ab0tj/MiniSys/CheapBus Pinout.xlsx

Pin | Name | Description | Type | Note
1 | GND | Ground | Power
2 | GND | Ground | Power
3 | GND | Ground | Power
4 | GND | Ground | Power
5 | GND | Ground | Power
6 | A23 | Address bus | Signal
7 | A22 | Address bus | Signal
8 | A21 | Address bus | Signal
9 | A20 | Address bus | Signal
10 | A19 | Address bus | Signal
11 | A18 | Address bus | Signal
12 | A17 | Address bus | Signal
13 | A16 | Address bus | Signal
14 | A15 | Address bus | Signal
15 | A14 | Address bus | Signal
16 | A13 | Address bus | Signal
17 | A12 | Address bus | Signal
18 | A11 | Address bus | Signal
19 | A10 | Address bus | Signal
20 | A9 | Address bus | Signal
21 | A8 | Address bus | Signal
22 | A7 | Address bus | Signal
23 | A6 | Address bus | Signal
24 | A5 | Address bus | Signal
25 | A4 | Address bus | Signal
26 | A3 | Address bus | Signal
27 | A2 | Address bus | Signal
28 | A1 | Address bus | Signal
29 | A0 | Address bus | Signal
30 | IOR* | IO Read | Signal
31 | IOW* | IO Write | Signal
32 | MEMR* | Memory Read | Signal
33 | MEMW* | Memory Write | Signal
34 | MOVL* | Memory Overlay Active | Signal | Similar to S100 PHANTOM* line
35 | IO16* | IO 16 bit | Signal | Addressed IO device supports 16 bit transfer
36 | M16* | Memory 16 bit | Signal | Addressed memory device supports 16 bit transfer
37 | BHE* | Bus High Enable | Signal
38 | CLK1 | System Clock | Signal
39 | CLK2 | Aux clock 1 | Signal
40 | CLK3 | Aux clock 2 | Signal
41 | CLK4 | Aux clock 3 | Signal
42 | IRQ14* | Interrupt 14 | Signal
43 | IRQ13* | Interrupt 13 | Signal
44 | IRQ12* | Interrupt 12 | Signal
45 | IRQ11* | Interrupt 11 | Signal
46 | IRQ10* | Interrupt 10 | Signal
47 | IRQ9* | Interrupt 9 | Signal
48 | IRQ8* | Interrupt 8 | Signal
49 | SPARE1 | Available (Terminated) | Signal
50 | SPARE2 | Available (Terminated) | Signal
51 | SPARE3 | Available (Terminated) | Signal
52 | SPARE4 | Available (Not terminated) | Undefined | Max 1A current capacity
53 | SPARE5 | Available (Not terminated) | Undefined | Max 1A current capacity
54 | SPARE6 | Available (Not terminated) | Undefined | Max 1A current capacity
55 | VBAT | Battery Voltage | Power
56 | -12V | Negative 12V | Power | Max 2A
57 | 3.3V | 3.3 Volts | Power
58 | 5V | 5 Volts | Power
59 | 5V | 5 Volts | Power
60 | 5V | 5 Volts | Power
61 | 5V | 5 Volts | Power
62 | 5V | 5 Volts | Power
63 | 5VSB | 5V Standby | Power | Max 2A
64 | 3.3V | 3.3 Volts | Power
65 | 12V | 12 Volts | Power | Max 2A
66 | D15 | Data bus | Signal
67 | D14 | Data bus | Signal
68 | D13 | Data bus | Signal
69 | D12 | Data bus | Signal
70 | D11 | Data bus | Signal
71 | D10 | Data bus | Signal
72 | D9 | Data bus | Signal
73 | D8 | Data bus | Signal
74 | D7 | Data bus | Signal
75 | D6 | Data bus | Signal
76 | D5 | Data bus | Signal
77 | D4 | Data bus | Signal
78 | D3 | Data bus | Signal
79 | D2 | Data bus | Signal
80 | D1 | Data bus | Signal
81 | D0 | Data bus | Signal
82 | HOLD* | CPU Hold Request | Signal
83 | HLDA* | Hold Acknowledge | Signal
84 | M1* | M1 Cycle | Signal | Memory read is an instruction fetch
85 | RFSH* | Refresh | Signal
86 | IOWT* | IO Wait | Signal | IO device requesting wait states
87 | MWT* | Memory Wait | Signal | Memory device requesting wait states
88 | EOP* | DMA End Of Process | Signal
89 | MASTER* | Master Request | Signal
90 | AEN* | Address Enable | Signal
91 | DRQ0* | DMA Request 0 | Signal
92 | DACK0* | DMA Acknowledge 0 | Signal
93 | DRQ1* | DMA Request 1 | Signal
94 | DACK1* | DMA Acknowledge 1 | Signal
95 | DRQ2* | DMA Request 2 | Signal
96 | DACK2* | DMA Acknowledge 2 | Signal
97 | DRQ3* | DMA Request 3 | Signal
98 | DACK3* | DMA Acknowledge 3 | Signal
99 | NMI* | Nonmaskable Interrupt | Signal
100 | INT* | Processor Interrupt | Signal
101 | INTA* | Interrupt Acknowledge | Signal
102 | IRQ7* | Interrupt 7 | Signal
103 | IRQ6* | Interrupt 6 | Signal
104 | IRQ5* | Interrupt 5 | Signal
105 | IRQ4* | Interrupt 4 | Signal
106 | IRQ3* | Interrupt 3 | Signal
107 | IRQ2* | Interrupt 2 | Signal
108 | IRQ1* | Interrupt 1 | Signal
109 | IRQ0* | Interrupt 0 | Signal
110 | SPARE7 | Available (Terminated) | Signal
111 | SPARE8 | Available (Terminated) | Signal
112 | SPARE9 | Available (Terminated) | Signal
113 | SDA | I2C Data | Signal
114 | SCL | I2C Clock | Signal
115 | RESET* | System Reset | Signal
116 | GND | Ground | Power
117 | GND | Ground | Power
118 | GND | Ground | Power
119 | GND | Ground | Power
120 | GND | Ground | Power
