ab0tj/MiniSys/Boards/Backplane/backplane.png

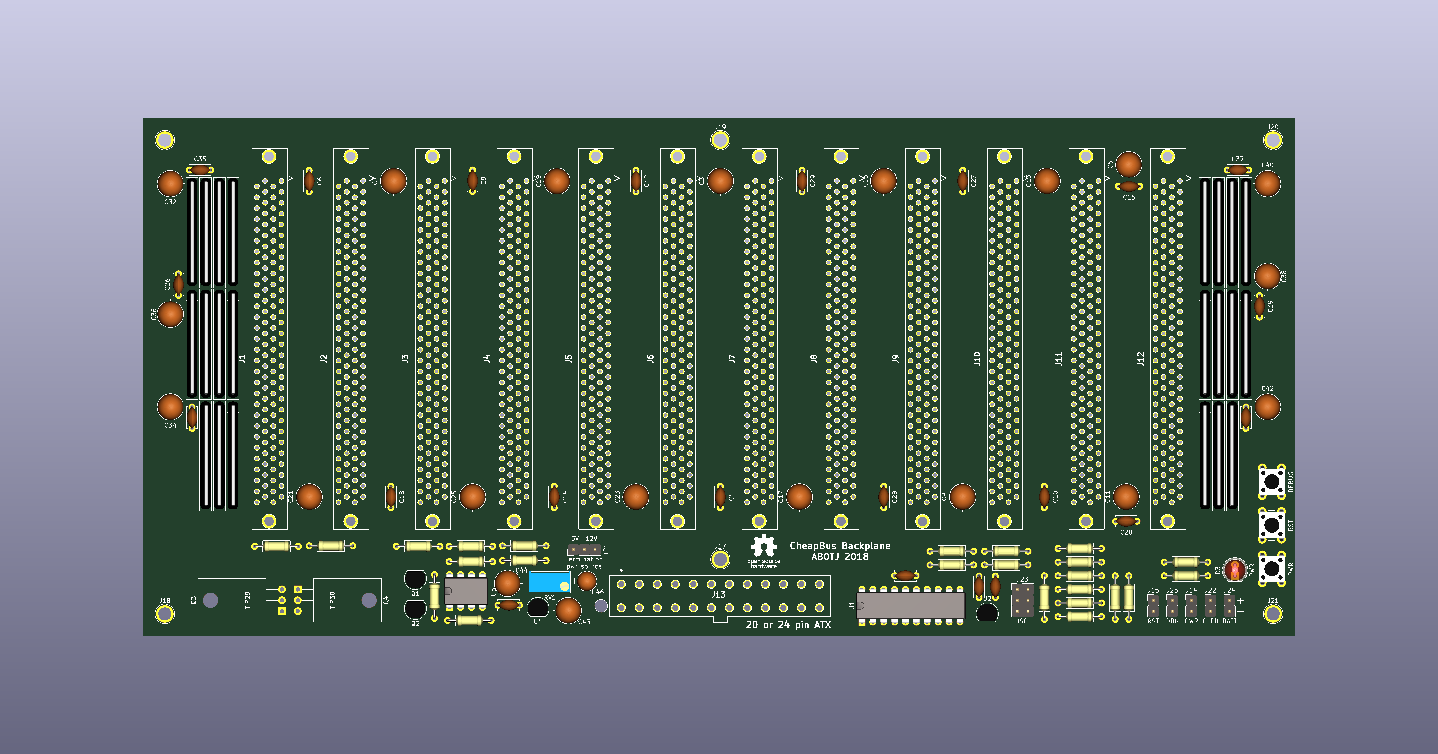
Boards/Backplane/backplane.png
