ab0tj/MiniSys/Boards/16MB DRAM/16MB DRAM.pdf

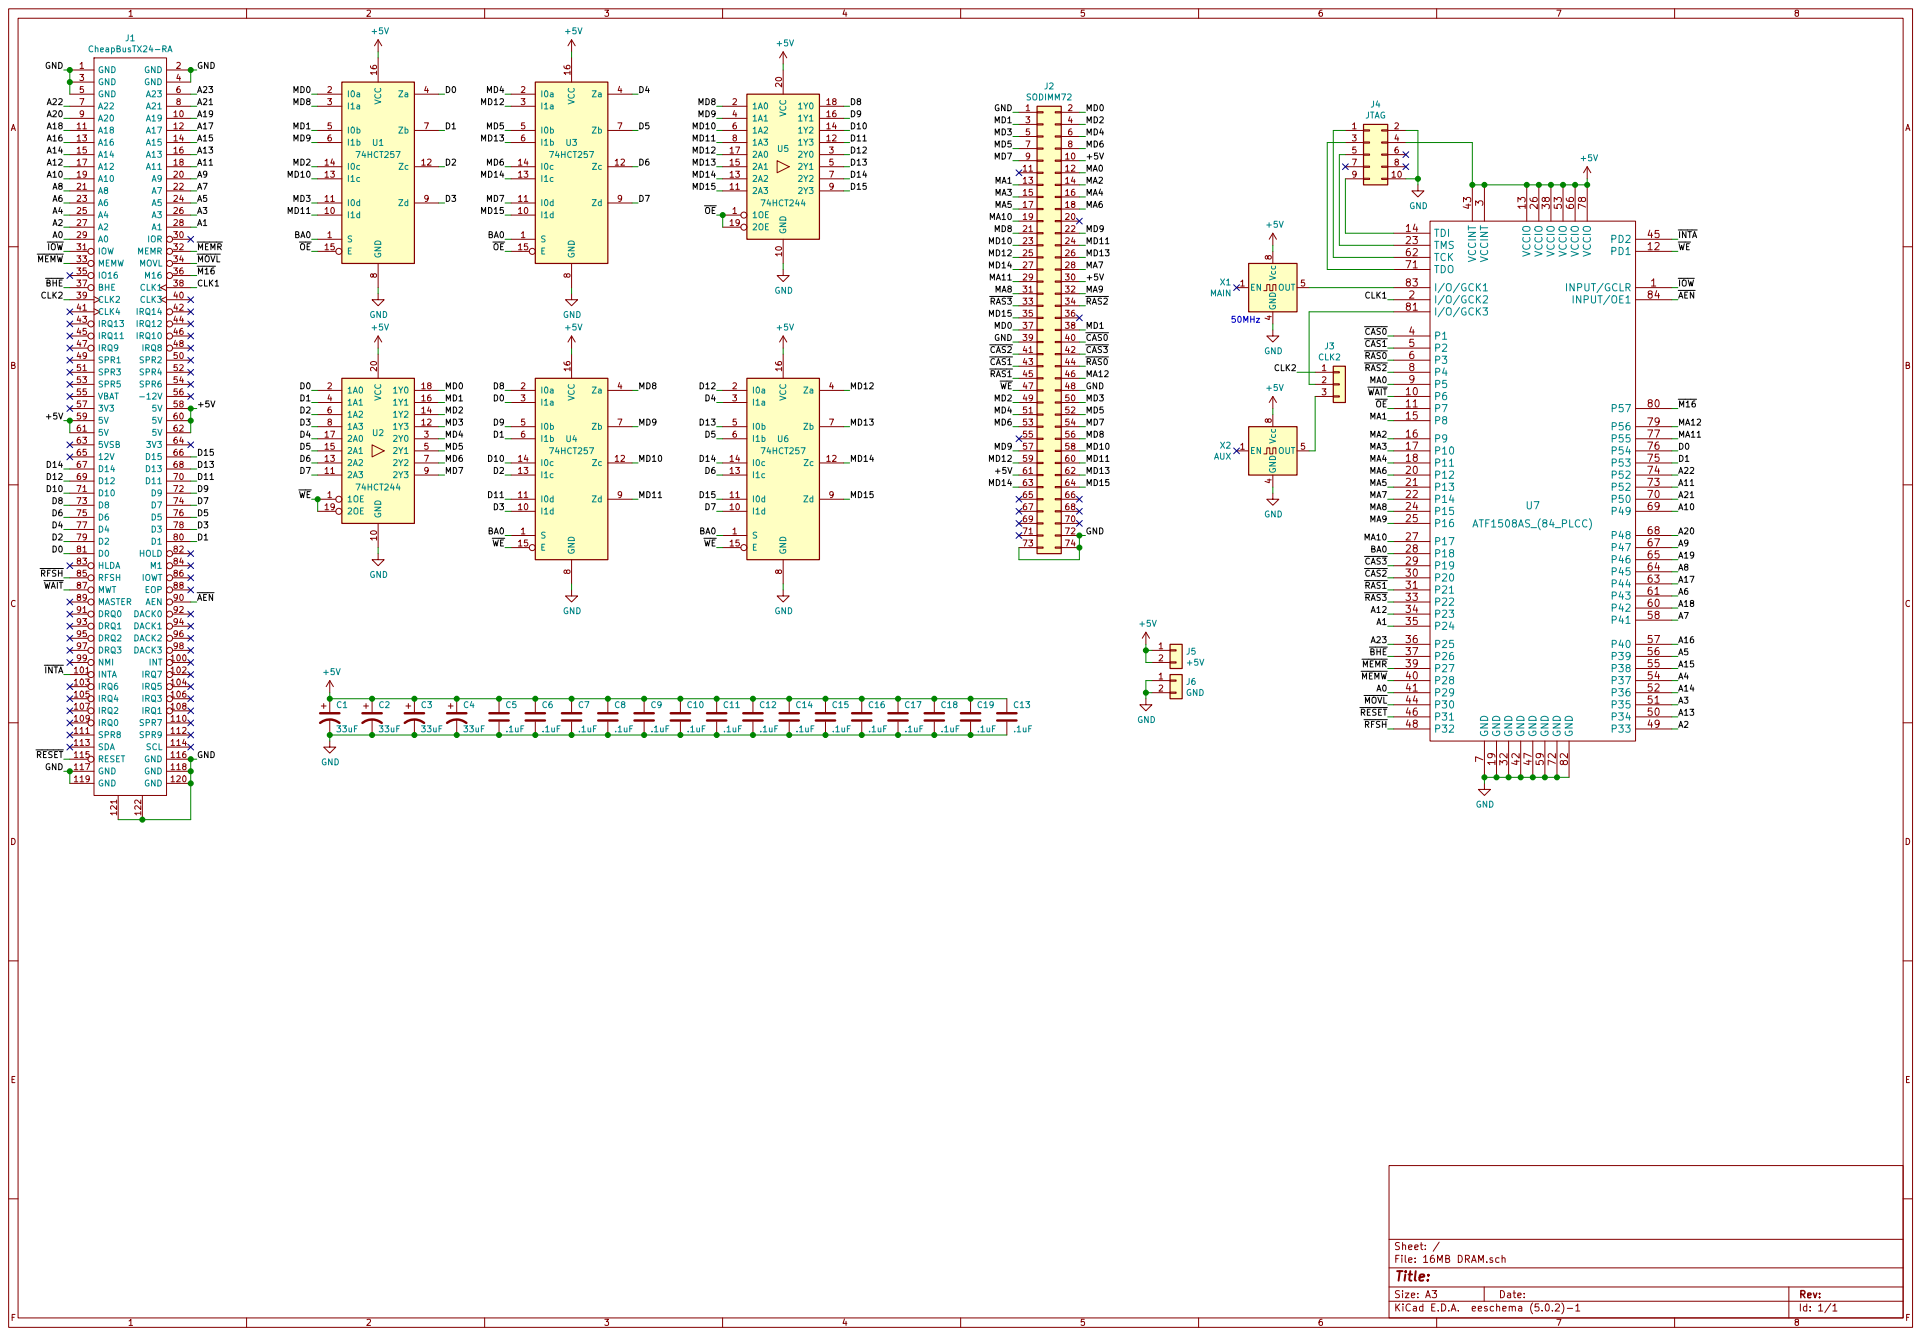
[picture p2: page 1]

3 P20 30 P21 31 GND 32 P22 33 P23 34 P24 35 P25 36 P26 37 VCCIO 38 P27 39 P1 4 P28 40 P29 41 GND 42 VCCINT 43 P30 44 PD2

4 OUT 5 Vcc 8 X1 MAIN GND

4 OUT 5 Vcc 8 X2 AUX GND

Id: 1/1 Title: File: 16MB DRAM.sch Sheet: /
