ab0tj/MiniSys/Boards/8085 CPU/8085 CPU.pdf

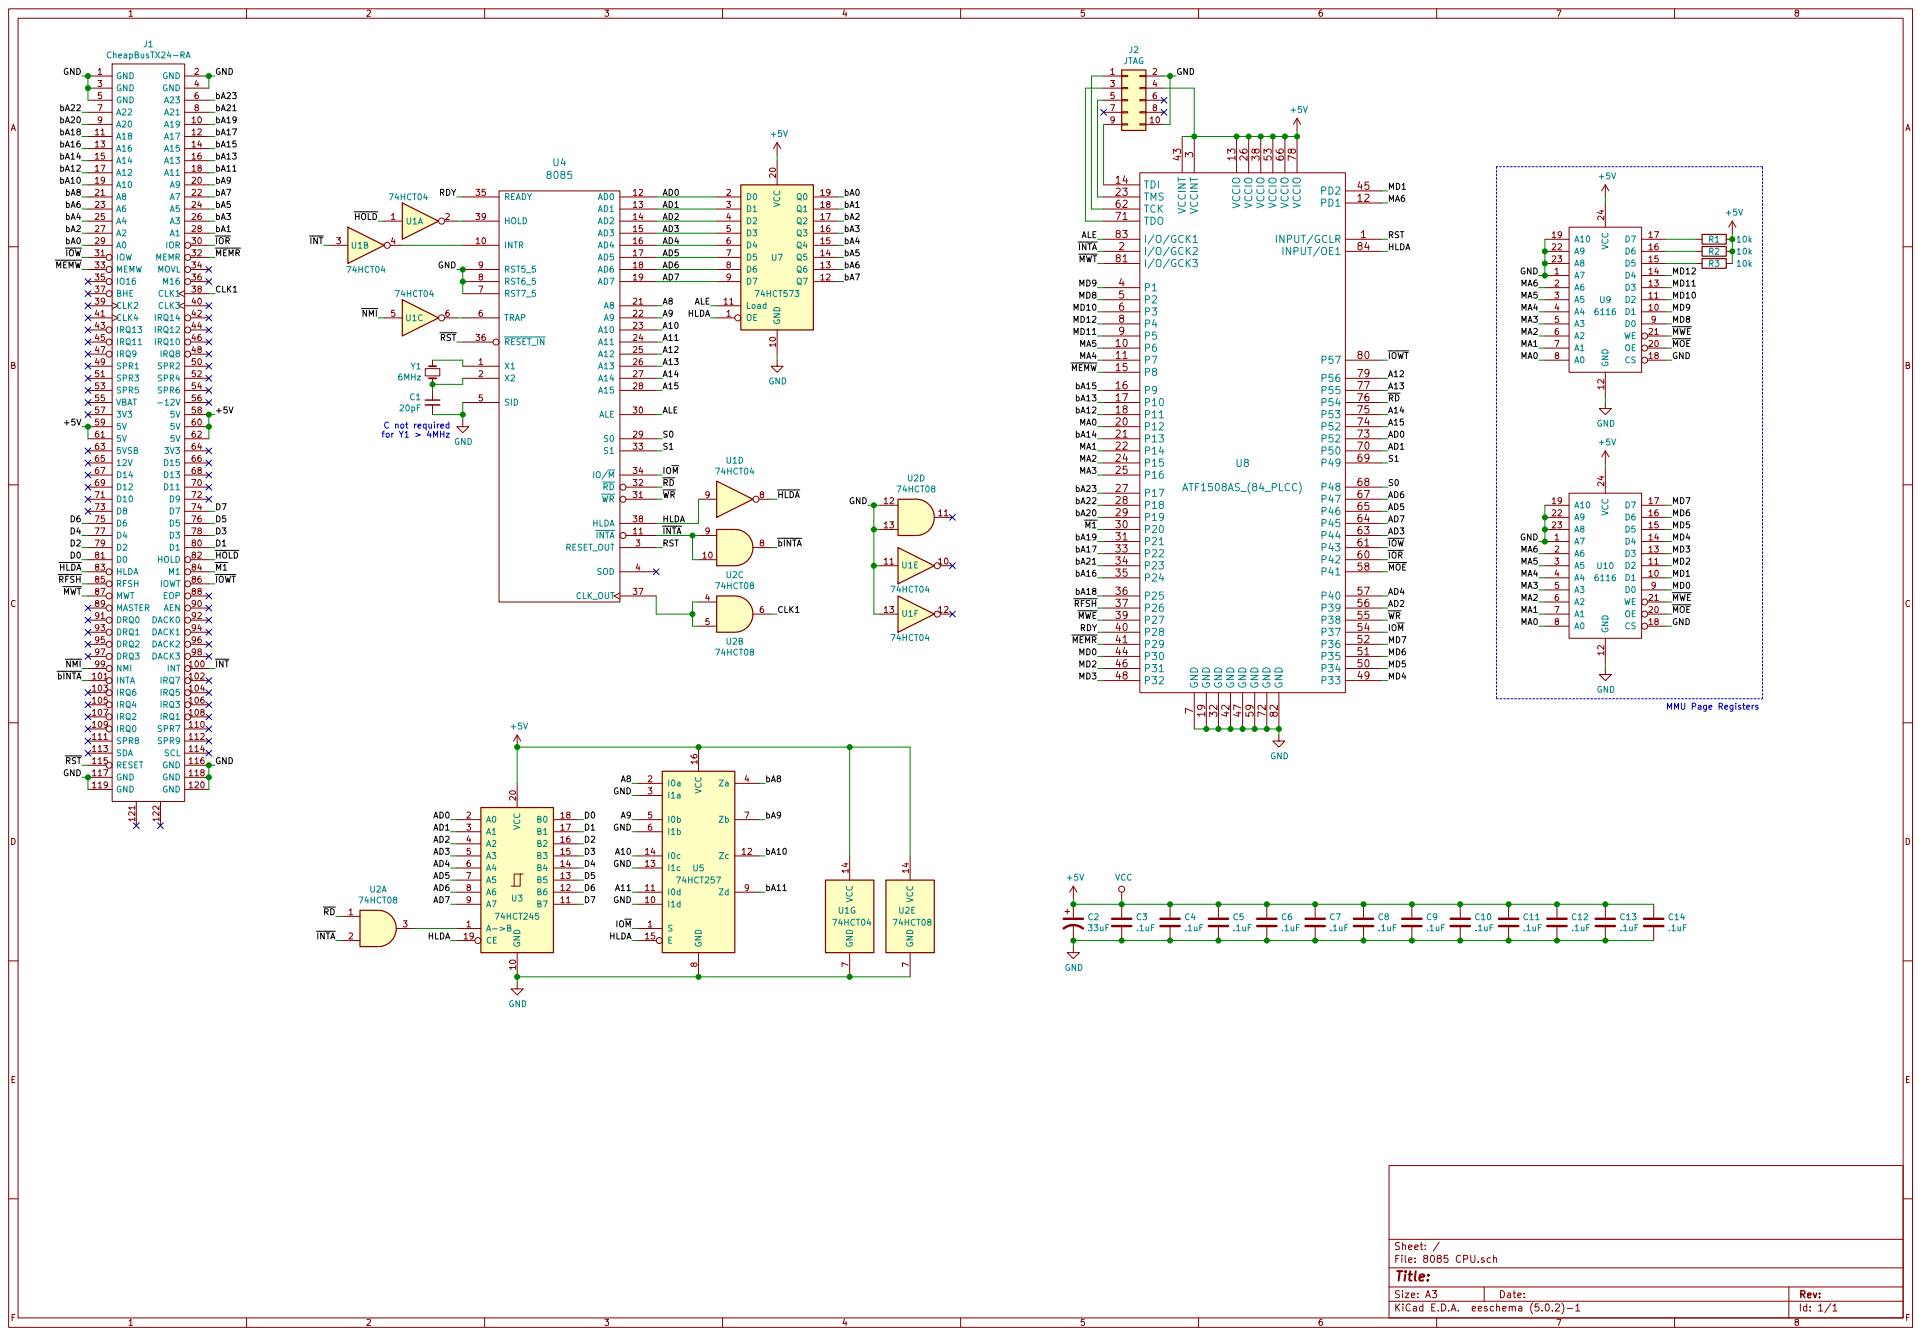
[picture p3: page 1]

74HCT257 HLDA GND GND GND GND

Id: 1/1 Title: File: 8085 CPU.sch Sheet: /
