ab0tj/MiniSys/Boards/Breakout/MiniSys-Breakout.pdf

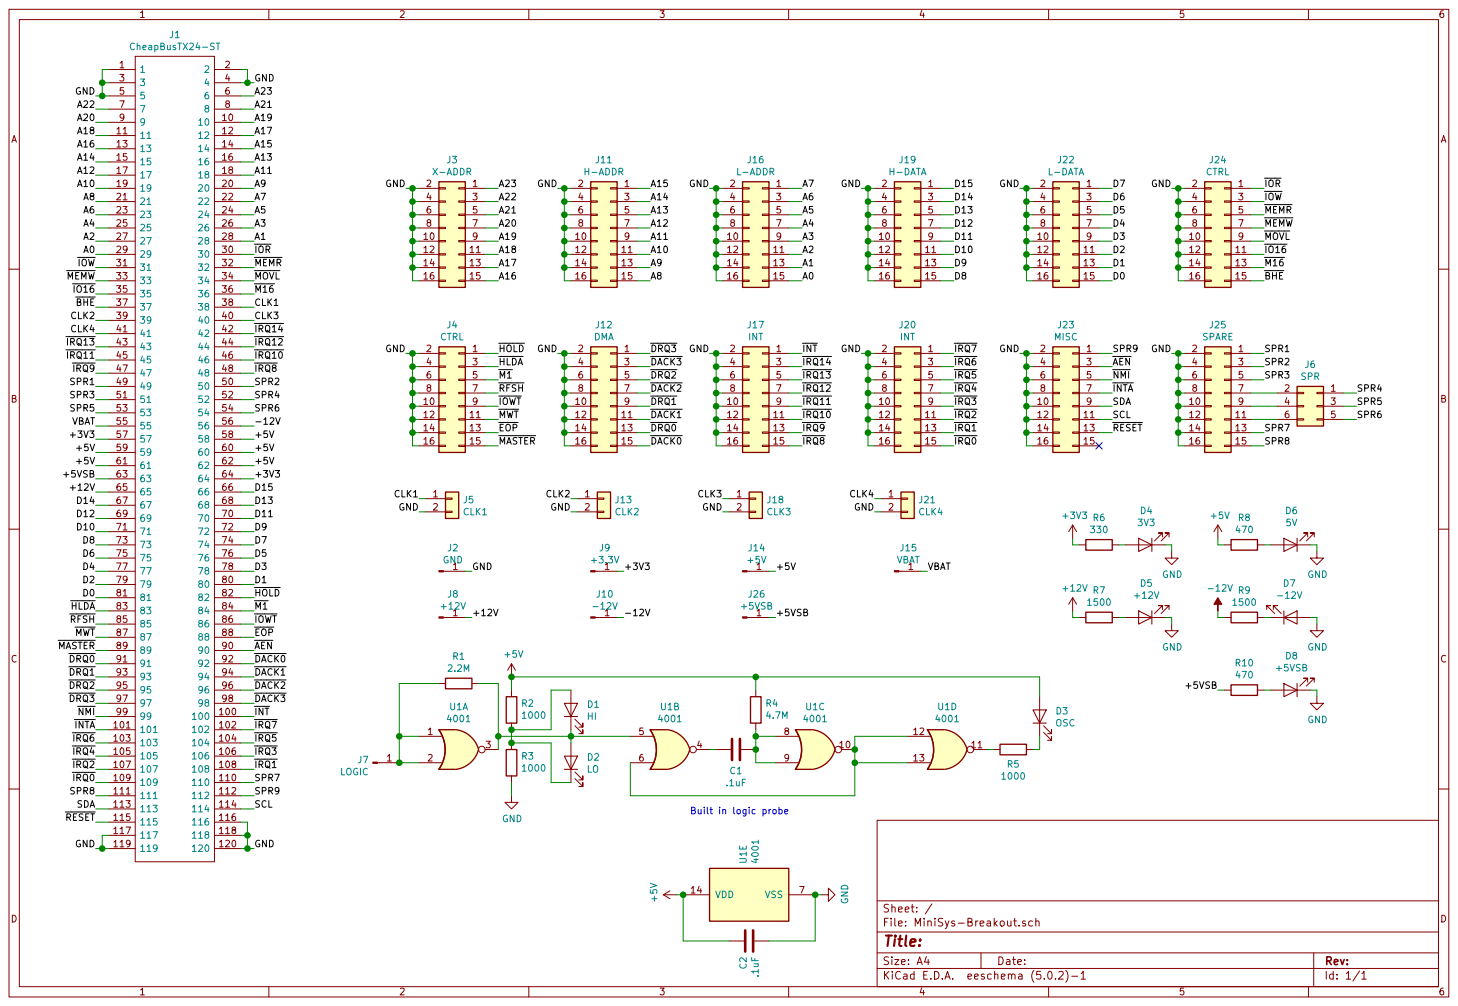
[picture p4: page 1]

File: MiniSys-Breakout.sch Sheet: / 1 1

+12V D14 D12 D10 D8 D6 D4 D2 D0 HLDA RFSH MWT MASTER

IOWT MWT EOP MASTER
