ab0tj/MiniSys/Boards/Pi Board/Pi Board.pdf

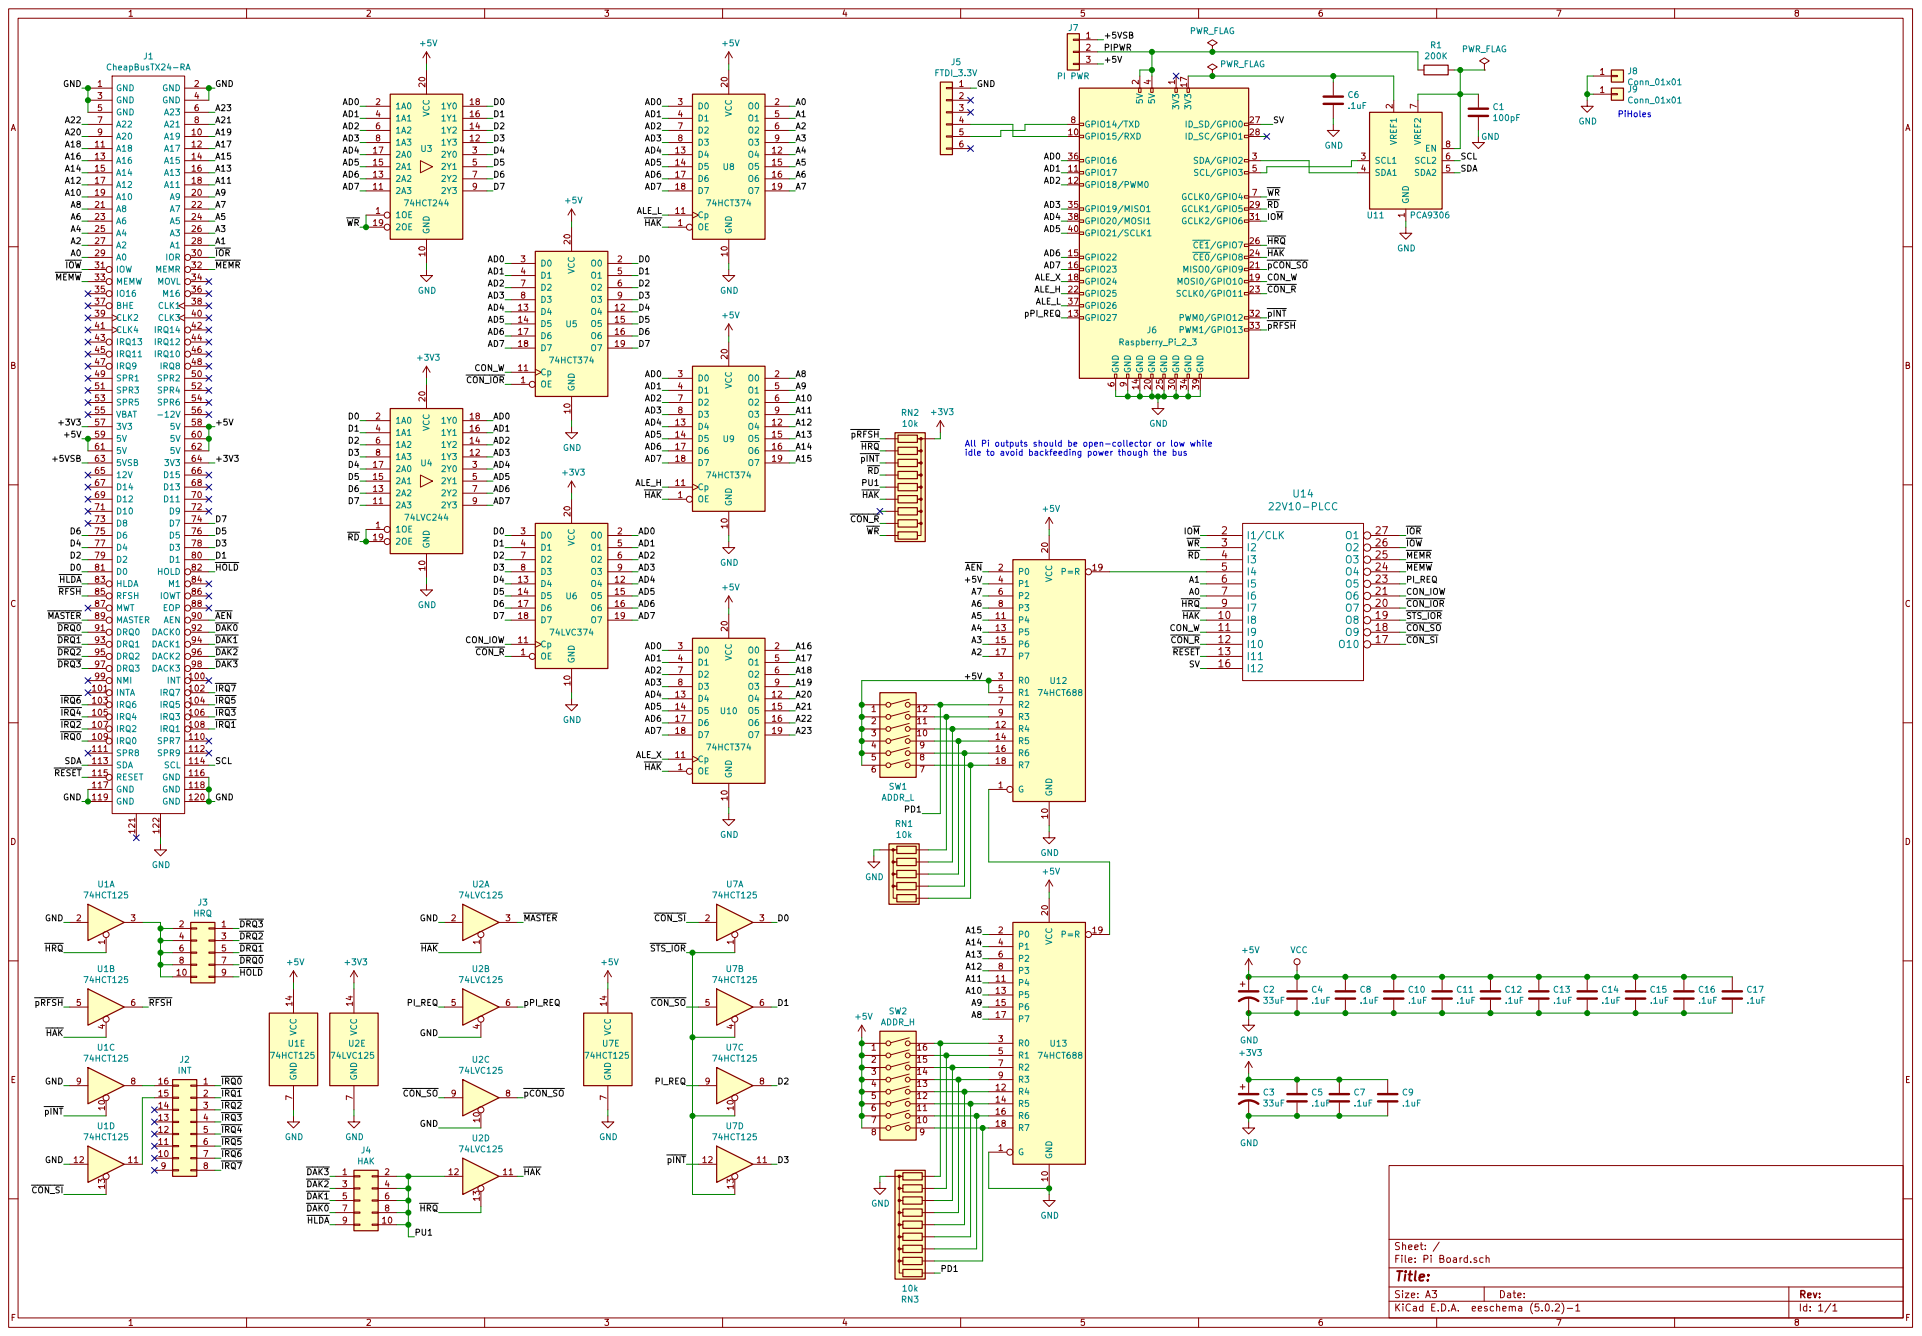
[picture p5: page 1]

All Pi outputs should be open-collector or low while

Id: 1/1 Title: File: Pi Board.sch Sheet: /
