ab0tj/MiniSys/Boards/PPR Board/PPR Board.pdf

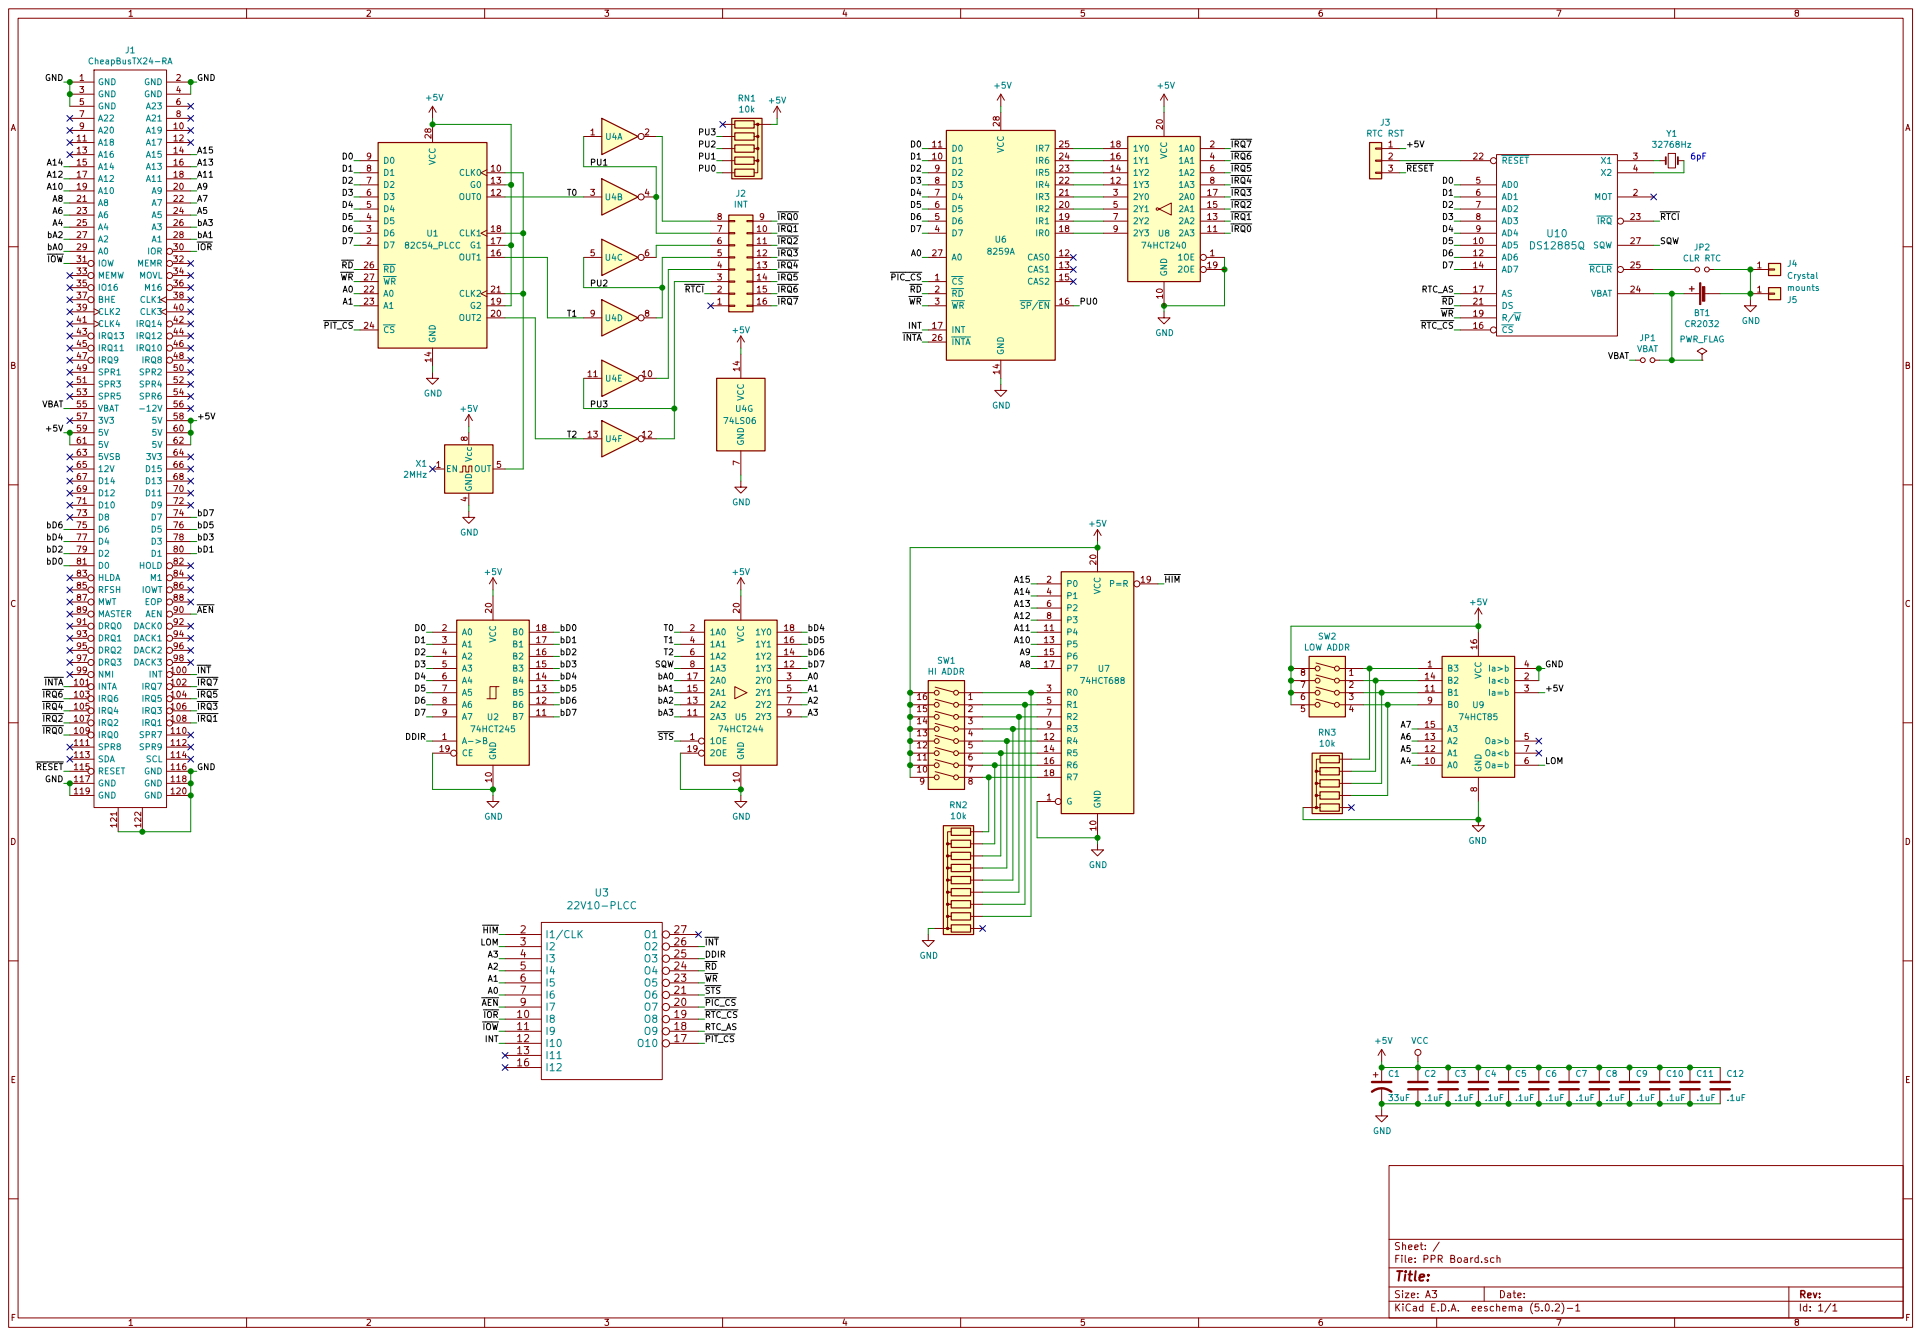
[picture p6: page 1]

Id: 1/1 Title: File: PPR Board.sch Sheet: /
