ab0tj/MiniSys/Boards/8MB SRAM/8MB SRAM.pdf

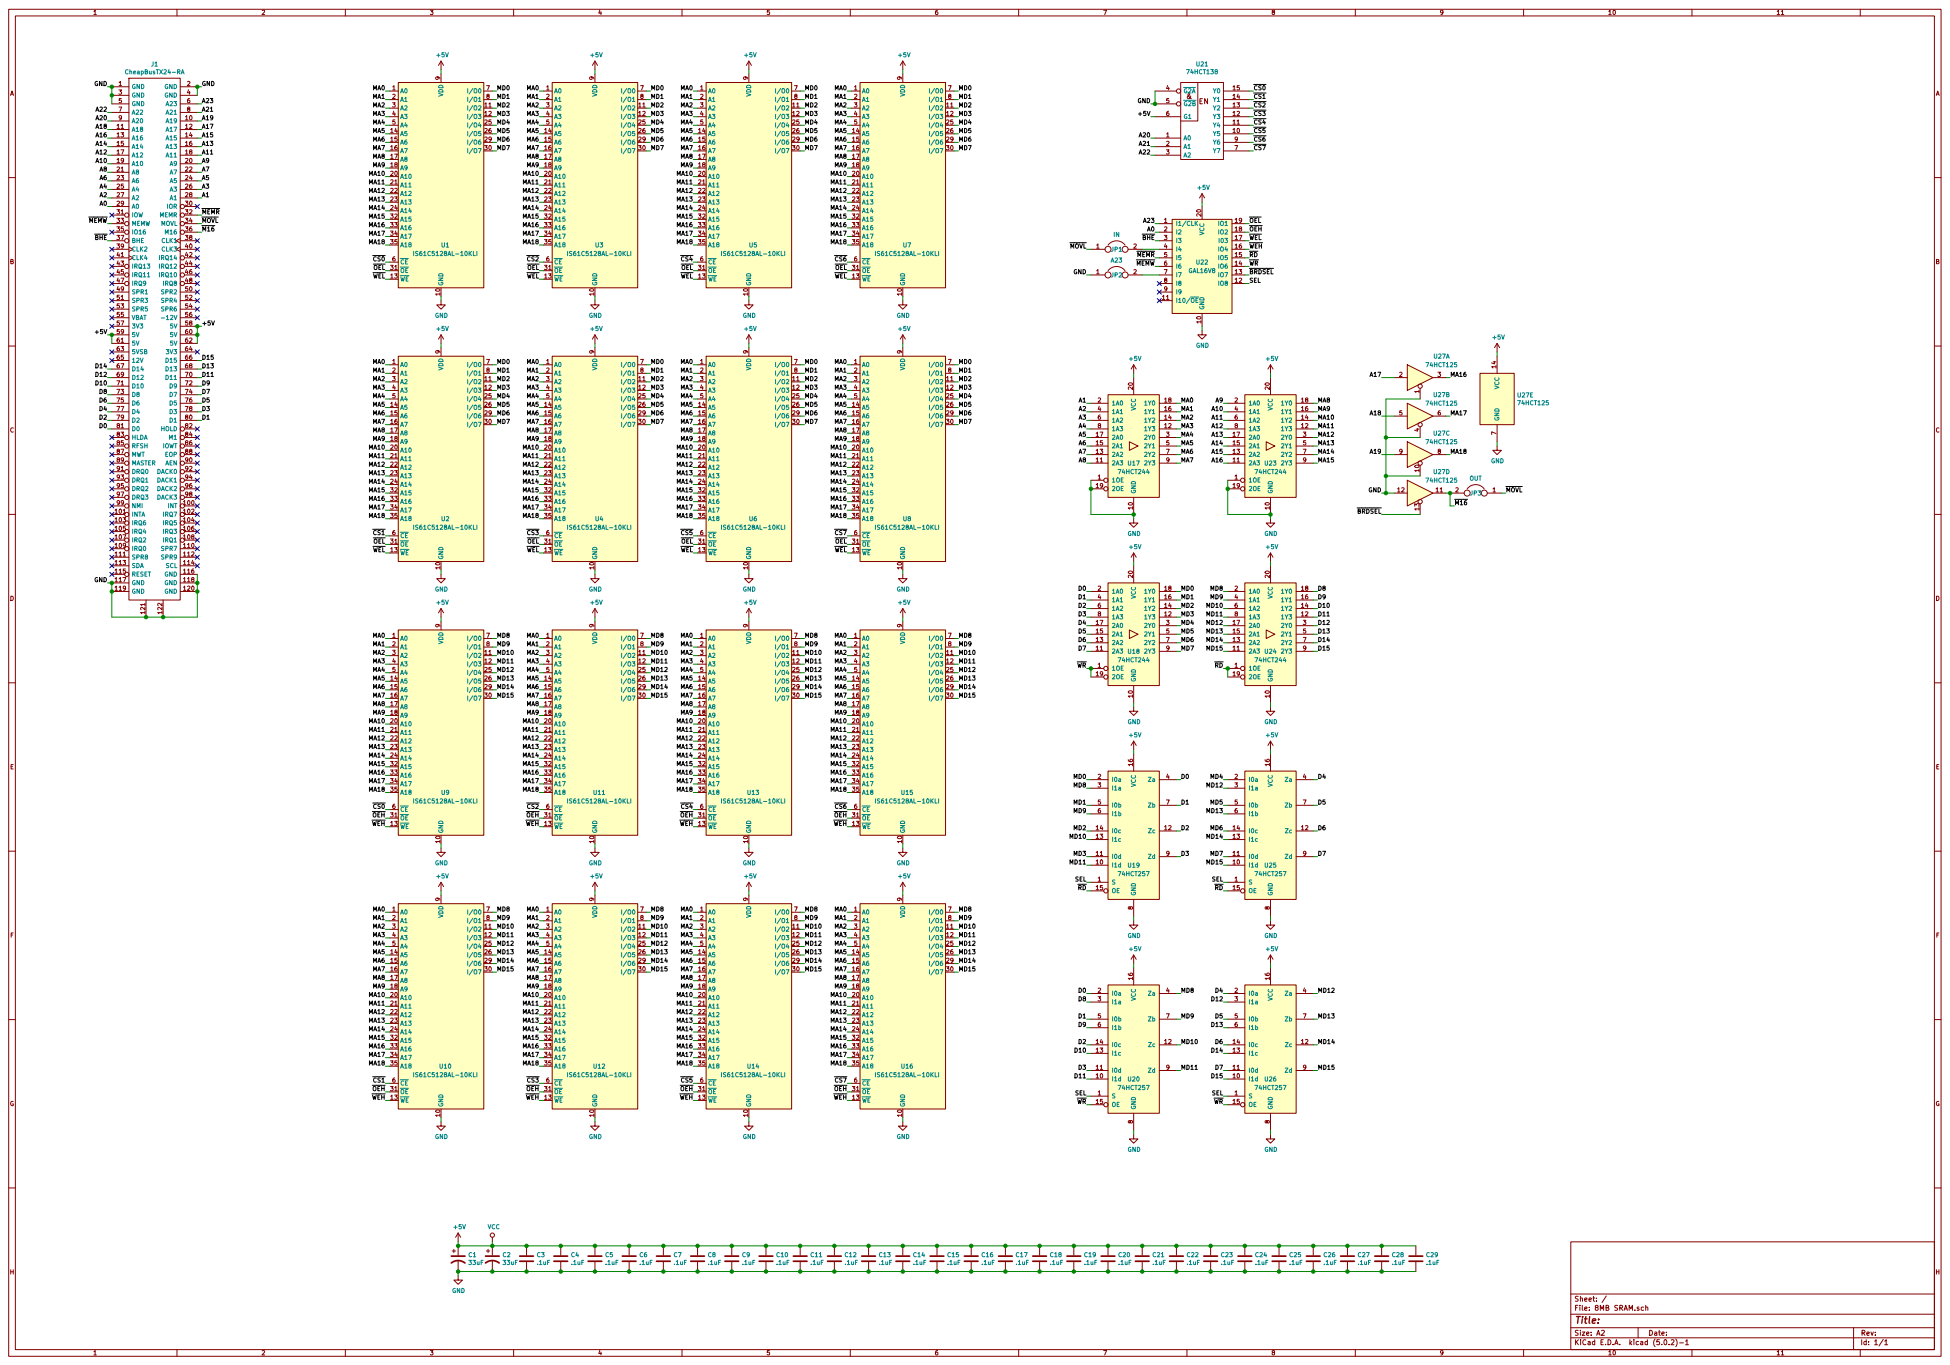
[picture p7: page 1]

Id: 1/1 Title: File: 8MB SRAM.sch Sheet: /
