ab0tj/MiniSys/Boards/Backplane/MiniSys-Backplane.pdf

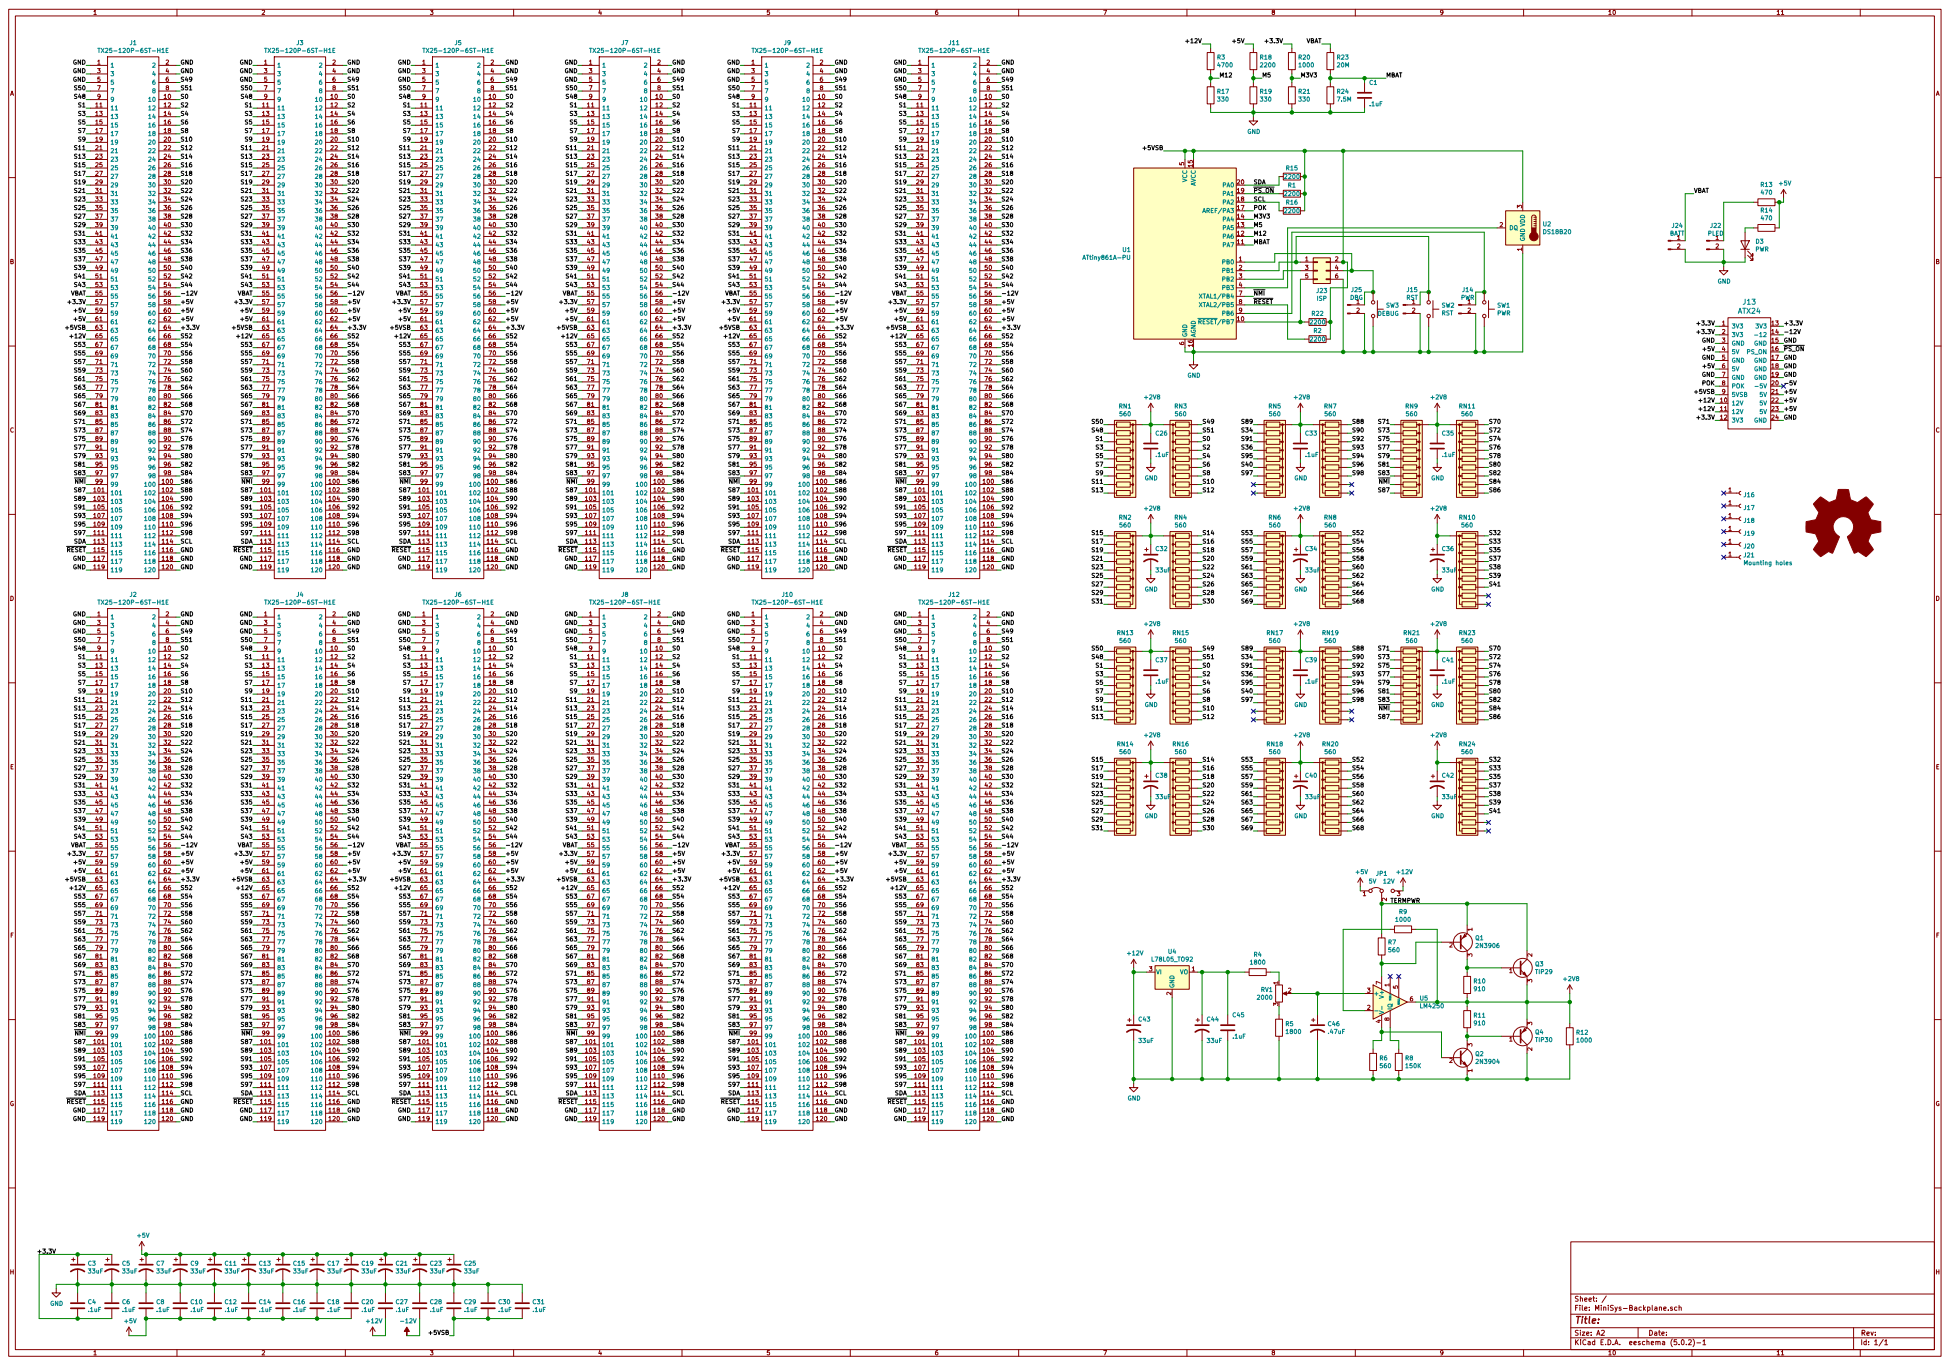
[picture p8: page 1]

File: MiniSys-Backplane.sch Sheet: /
