ab0tj/MiniSys/Boards/Ethernet/Ethernet.pdf

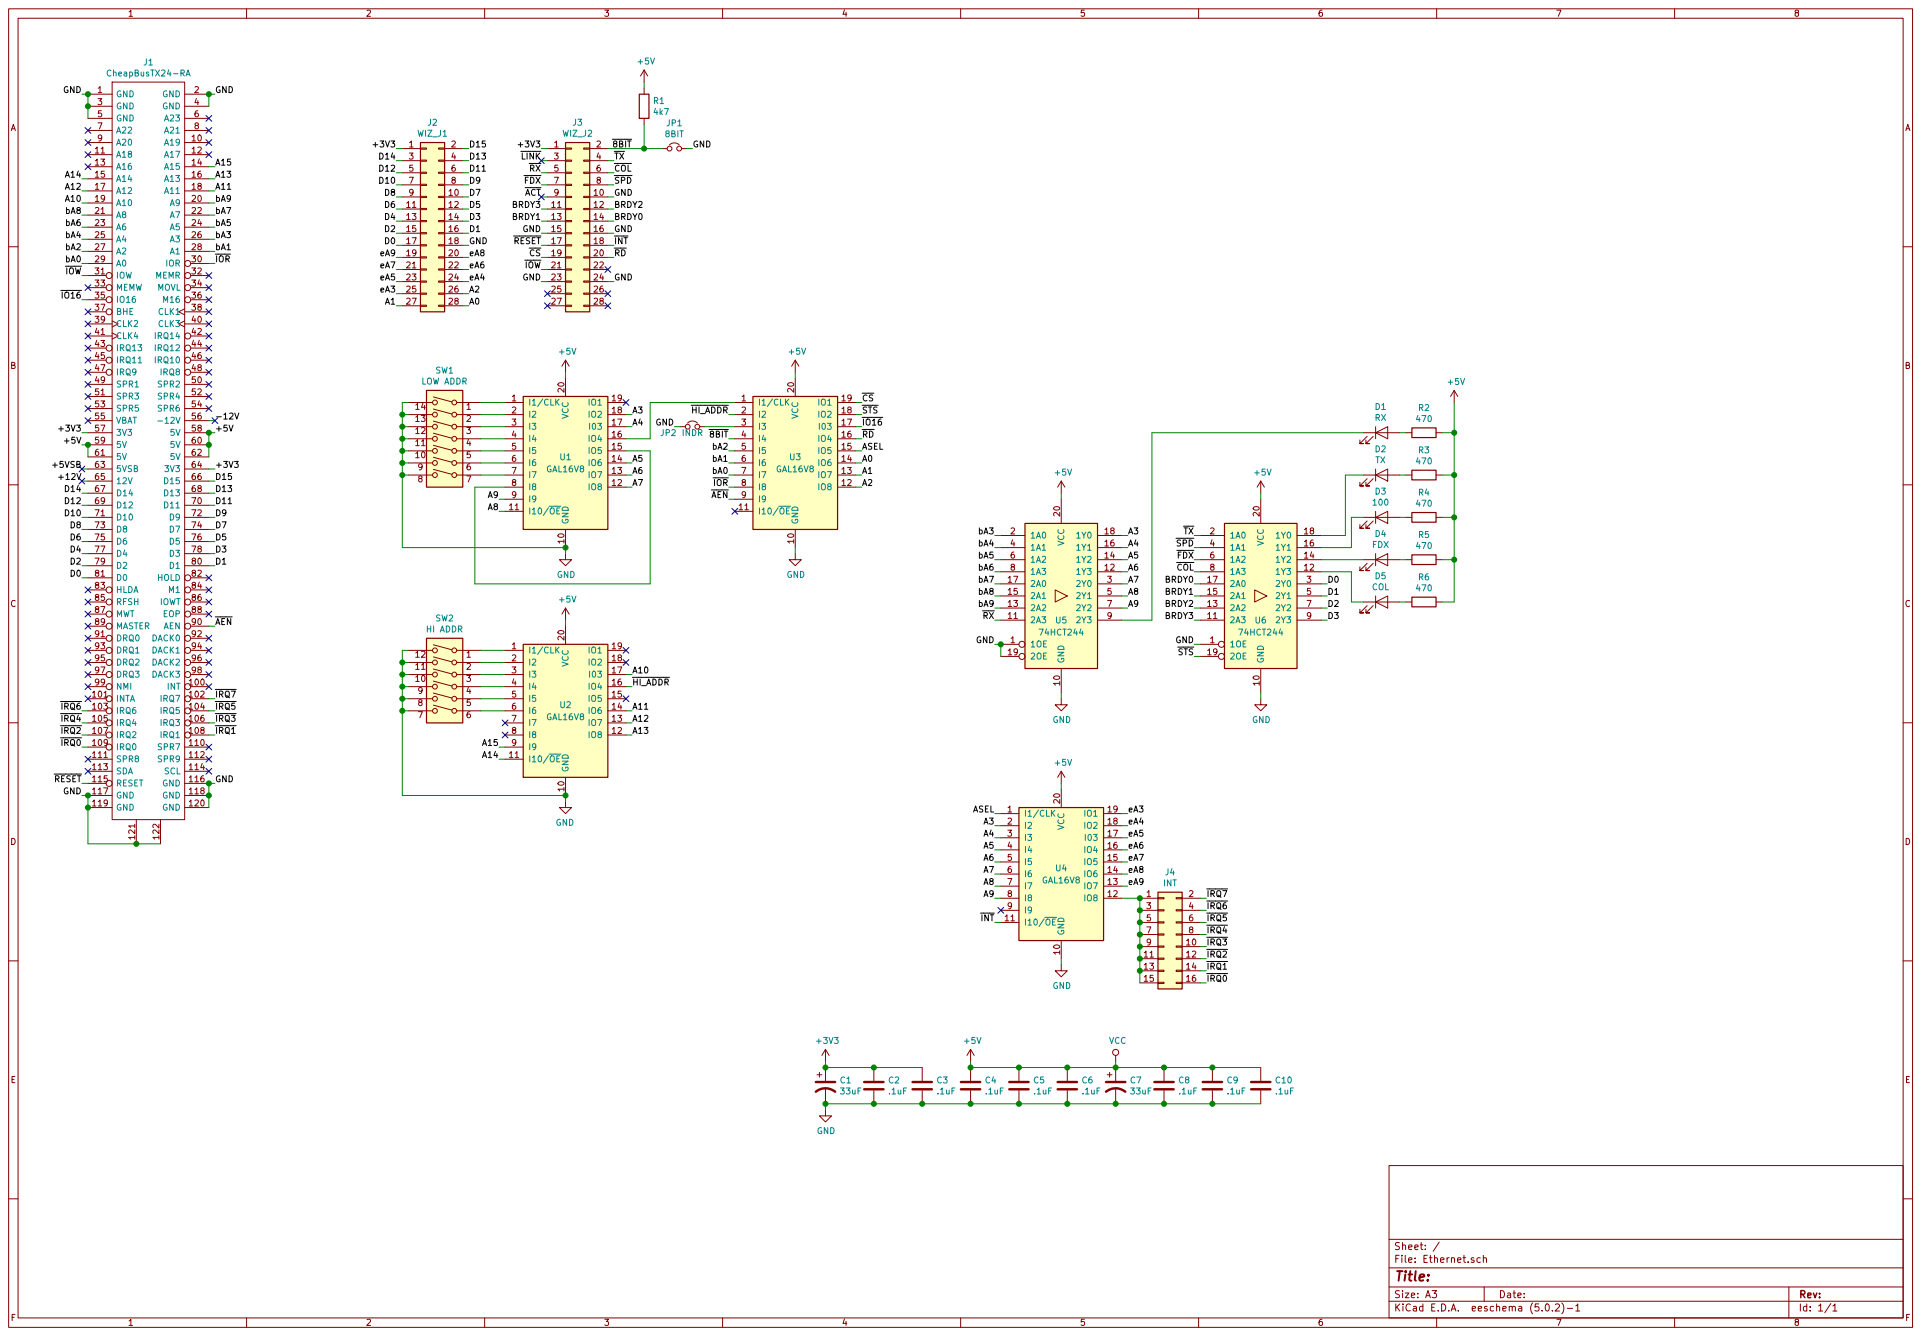
[picture p9: page 1]

Id: 1/1 Title: File: Ethernet.sch Sheet: /
