ab0tj/MiniSys/Boards/Backplane/MiniSys-Backplane.kicad_pcb

## KiCad design Boards/Backplane/MiniSys-Backplane.kicad_pcb (continued)

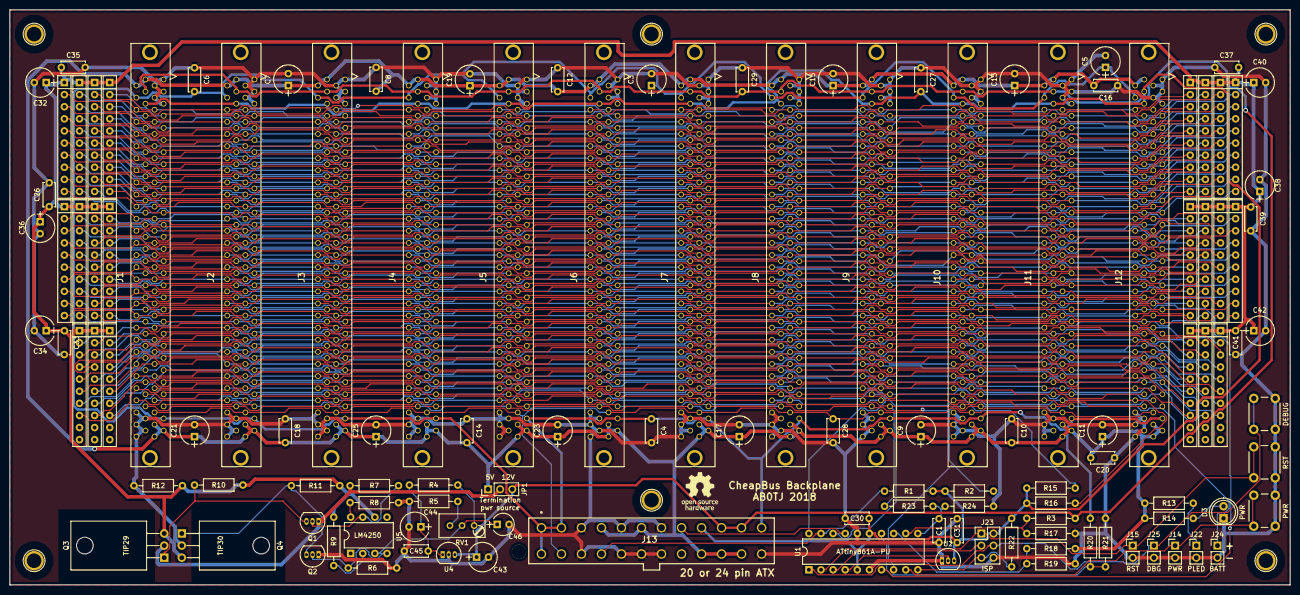
[picture p13: board MiniSys-Backplane.kicad_pcb from above]

Board: 2 copper layers, 268.6 x 120.7 mm, 129 parts (0 on the bottom side), 132 nets.
