ab0tj/MiniSys/Boards/Ethernet/Ethernet.kicad_pcb

## KiCad design Boards/Ethernet/Ethernet.kicad_pcb (2020-03-27)

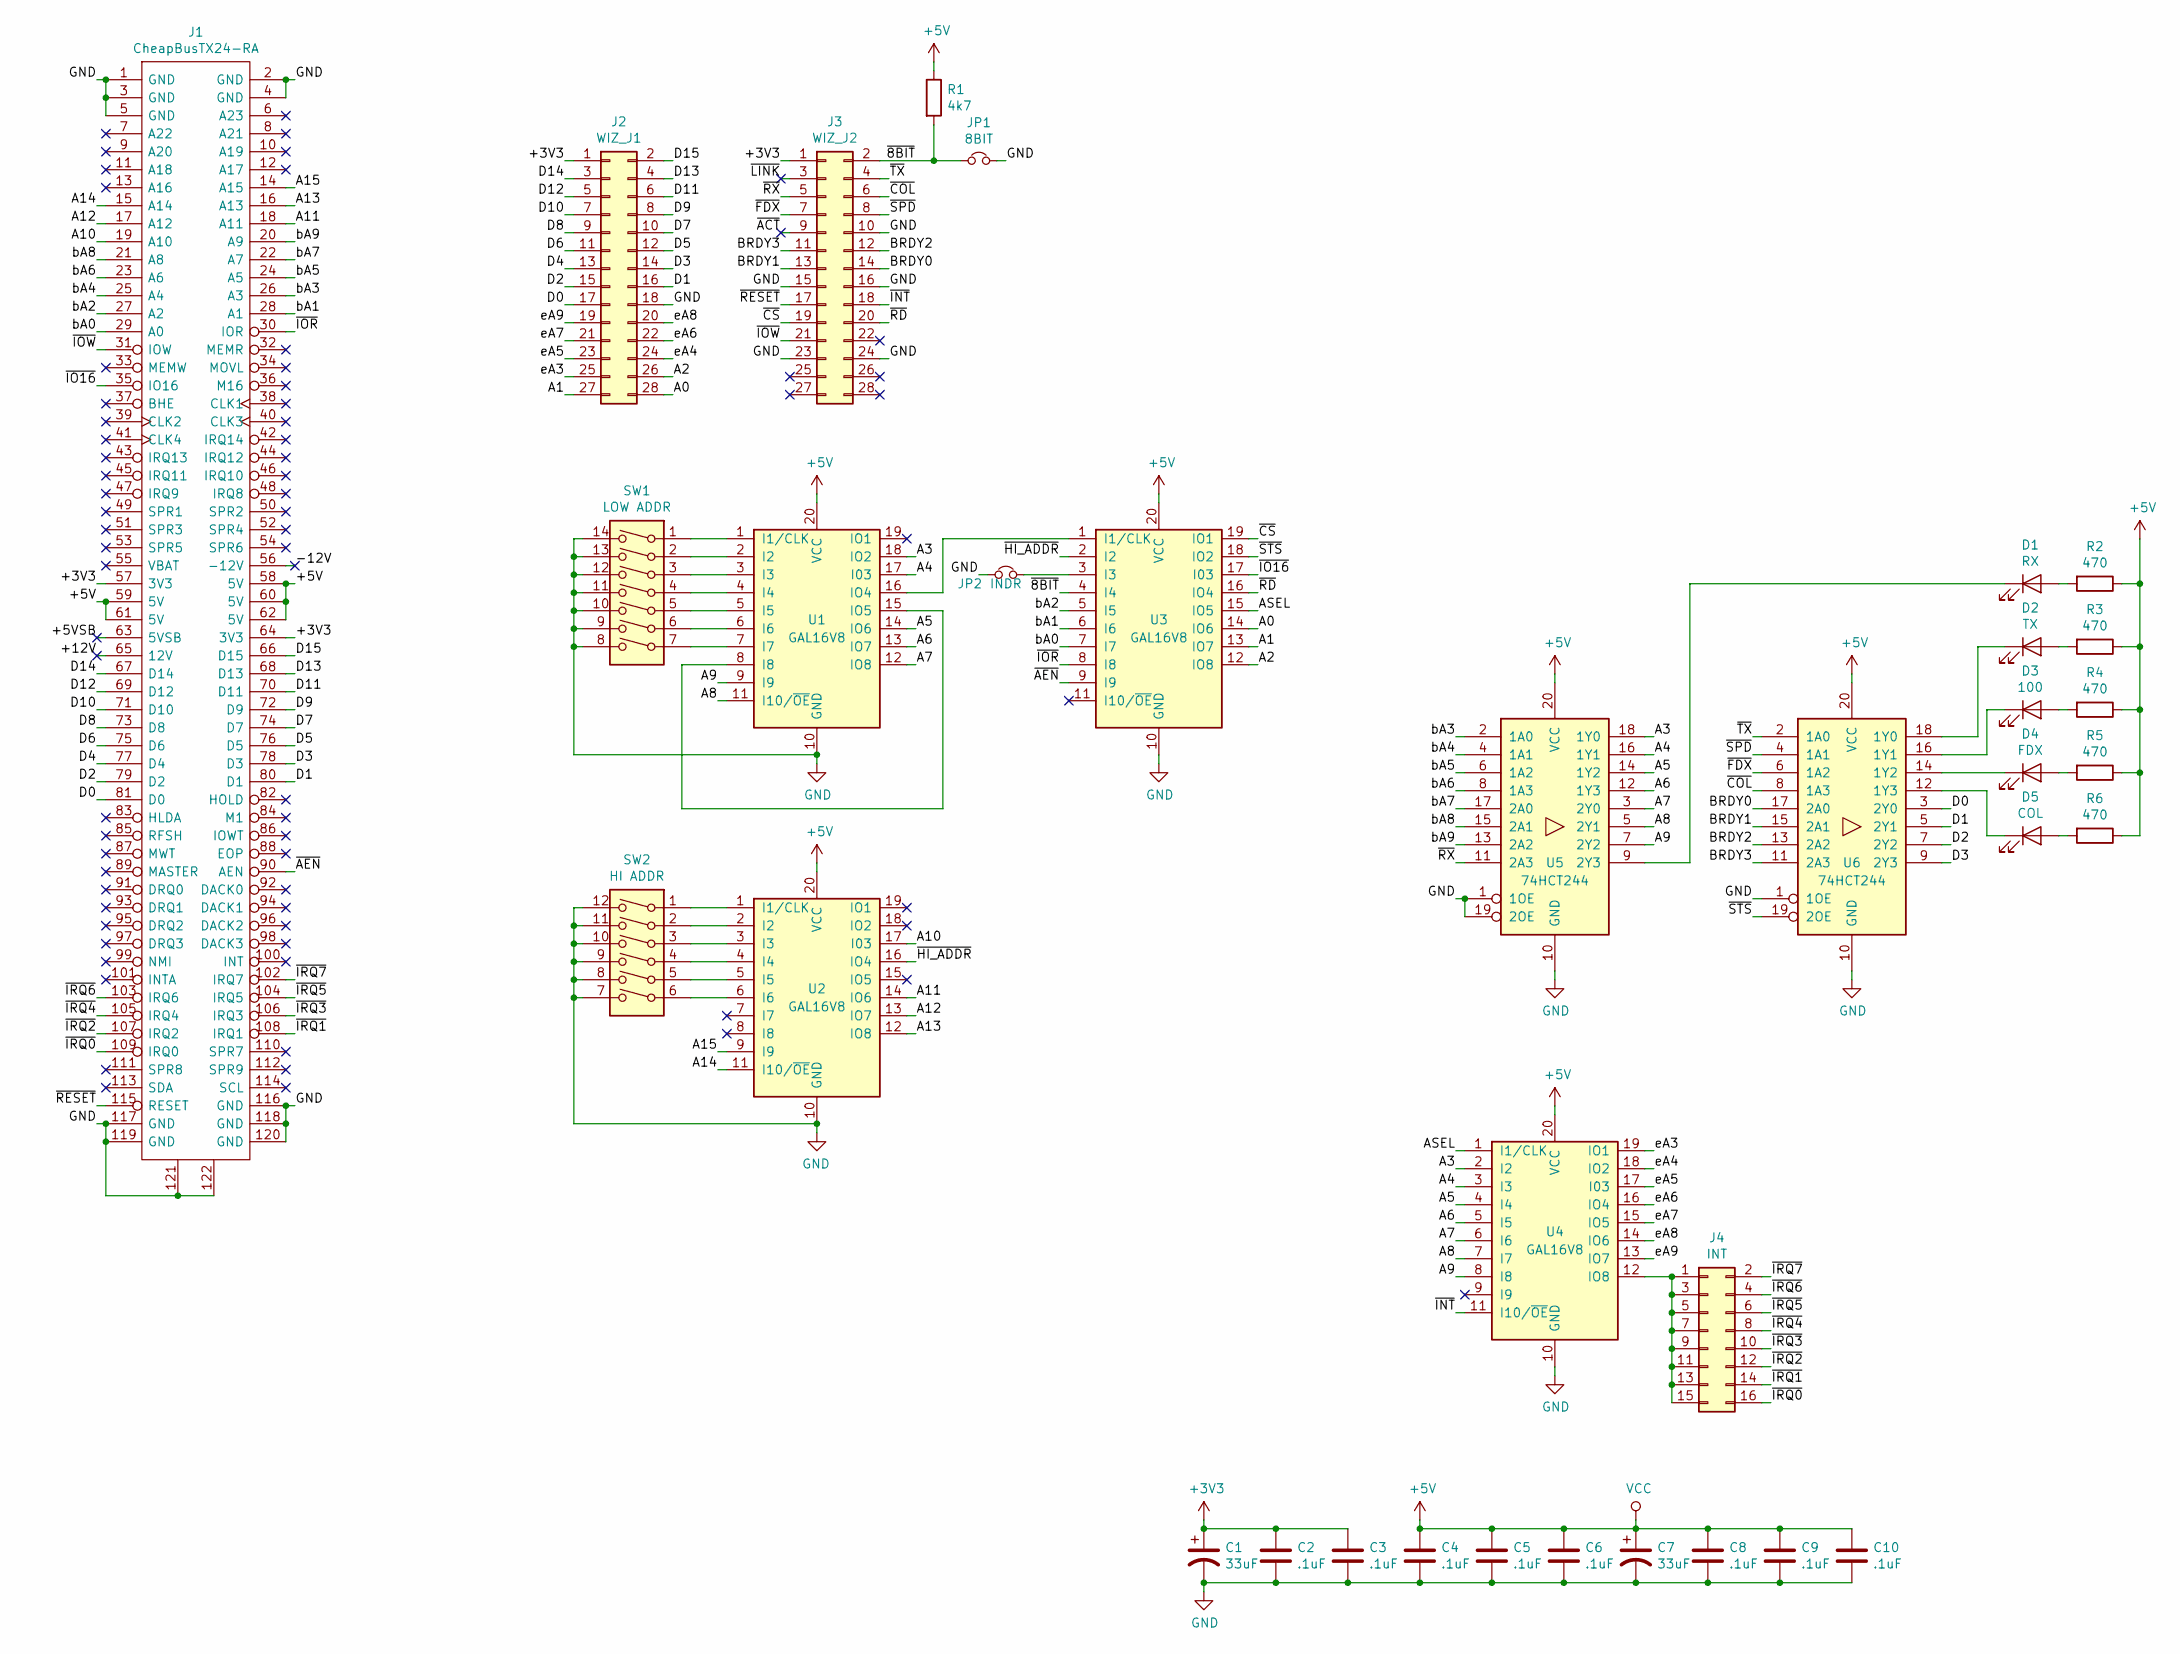
[picture p16: schematic Ethernet.sch]

Parts:
C1, C7: 33uF; CP_Radial_Tantal_D5.5mm_P2.50mm
C2, C3, C4, C5, C6, C8, C9, C10: .1uF; C_Disc_D3.0mm_W1.6mm_P2.50mm
D1: RX; LED_D3.0mm
D2: TX; LED_D3.0mm
D3: 100; LED_D3.0mm
D4: FDX; LED_D3.0mm
D5: COL; LED_D3.0mm
J1: CheapBusTX24-RA; JAE_TX24-120R-LT-H1E; Mouser Part Number 656-TX24120RLTH1E
J2: WIZ_J1; Pin_Header_Straight_2x14_Pitch2.54mm
J3: WIZ_J2; Pin_Header_Straight_2x14_Pitch2.54mm
J4: INT; Pin_Header_Straight_2x08_Pitch2.54mm
JP1: 8BIT; Pin_Header_Straight_1x02_Pitch2.54mm
JP2: INDR; Pin_Header_Straight_1x02_Pitch2.54mm
R1: 4k7; R_Axial_DIN0207_L6.3mm_D2.5mm_P10.16mm_Horizontal
R2, R3, R4, R5, R6: 470; R_Axial_DIN0207_L6.3mm_D2.5mm_P10.16mm_Horizontal
SW1: LOW ADDR; SW_DIP_x7_W7.62mm_Slide
SW2: HI ADDR; SW_DIP_x6_W7.62mm_Slide
U1, U2, U3, U4: GAL16V8; DIP-20_W7.62mm
U5, U6: 74HCT244; DIP-20_W7.62mm

Connections:
+3V3: C1.1, C2.1, C3.1, J1.57 (3V3), J1.64 (3V3), J2.1, J3.1
+5V: C4.1, C5.1, C6.1, C7.1, C8.1, C9.1, C10.1, J1.58 (5V), J1.59 (5V), J1.60 (5V), J1.61 (5V), J1.62 (5V), R1.1, R2.1, R3.1, R4.1, R5.1, R6.1, U1.20 (VCC), U2.20 (VCC), U3.20 (VCC), U4.20 (VCC), U5.20 (VCC), U6.20 (VCC)
/+5VSB: J1.63 (5VSB)
/+12V: J1.65 (12V)
/-12V: J1.56 (-12V)
/A0: J2.28, U3.14 (IO6)
/A1: J2.27, U3.13 (IO7)
/A2: J2.26, U3.12 (IO8)
/A3: U1.18 (IO2), U4.2 (I2), U5.18 (1Y0)
/A4: U1.17 (I03), U4.3 (I3), U5.16 (1Y1)
/A5: U1.14 (IO6), U4.4 (I4), U5.14 (1Y2)
/A6: U1.13 (IO7), U4.5 (I5), U5.12 (1Y3)
/A7: U1.12 (IO8), U4.6 (I6), U5.3 (2Y0)
/A8: U1.11 (I10/~OE~), U4.7 (I7), U5.5 (2Y1)
/A9: U1.9 (I9), U4.8 (I8), U5.7 (2Y2)
/A10: J1.19 (A10), U2.17 (I03)
/A11: J1.18 (A11), U2.14 (IO6)
/A12: J1.17 (A12), U2.13 (IO7)
/A13: J1.16 (A13), U2.12 (IO8)
/A14: J1.15 (A14), U2.11 (I10/~OE~)
/A15: J1.14 (A15), U2.9 (I9)
/ASEL: U3.15 (IO5), U4.1 (I1/CLK)
/BRDY0: J3.14, U6.17 (2A0)
/BRDY1: J3.13, U6.15 (2A1)
/BRDY2: J3.12, U6.13 (2A2)
/BRDY3: J3.11, U6.11 (2A3)
/D0: J1.81 (D0), J2.17, U6.3 (2Y0)
/D1: J1.80 (D1), J2.16, U6.5 (2Y1)
/D2: J1.79 (D2), J2.15, U6.7 (2Y2)
/D3: J1.78 (D3), J2.14, U6.9 (2Y3)
/D4: J1.77 (D4), J2.13
/D5: J1.76 (D5), J2.12
/D6: J1.75 (D6), J2.11
/D7: J1.74 (D7), J2.10
/D8: J1.73 (D8), J2.9
/D9: J1.72 (D9), J2.8
/D10: J1.71 (D10), J2.7
/D11: J1.70 (D11), J2.6
/D12: J1.69 (D12), J2.5
/D13: J1.68 (D13), J2.4
/D14: J1.67 (D14), J2.3
/D15: J1.66 (D15), J2.2
/bA0: J1.29 (A0), U3.7 (I7)
/bA1: J1.28 (A1), U3.6 (I6)
/bA2: J1.27 (A2), U3.5 (I5)
/bA3: J1.26 (A3), U5.2 (1A0)
/bA4: J1.25 (A4), U5.4 (1A1)
/bA5: J1.24 (A5), U5.6 (1A2)
/bA6: J1.23 (A6), U5.8 (1A3)
/bA7: J1.22 (A7), U5.17 (2A0)
/bA8: J1.21 (A8), U5.15 (2A1)
/bA9: J1.20 (A9), U5.13 (2A2)
/eA3: J2.25, U4.19 (IO1)
/eA4: J2.24, U4.18 (IO2)
/eA5: J2.23, U4.17 (I03)
/eA6: J2.22, U4.16 (IO4)
/eA7: J2.21, U4.15 (IO5)
/eA8: J2.20, U4.14 (IO6)
/eA9: J2.19, U4.13 (IO7)
/~8BIT: J3.2, JP1.1, R1.2, U3.4 (I4)
/~ACT: J3.9
/~AEN: J1.90 (AEN), U3.9 (I9)
/~COL: J3.6, U6.8 (1A3)
/~CS: J3.19, U3.19 (IO1)
/~FDX: J3.7, U6.6 (1A2)
/~HI_ADDR: U2.16 (IO4), U3.2 (I2)
/~INT: J3.18, U4.11 (I10/~OE~)
/~IO16: J1.35 (IO16), U3.17 (I03)
/~IOR: J1.30 (IOR), U3.8 (I8)
/~IOW: J1.31 (IOW), J3.21
/~IRQ0: J1.109 (IRQ0), J4.16
/~IRQ1: J1.108 (IRQ1), J4.14
/~IRQ2: J1.107 (IRQ2), J4.12
/~IRQ3: J1.106 (IRQ3), J4.10
/~IRQ4: J1.105 (IRQ4), J4.8
/~IRQ5: J1.104 (IRQ5), J4.6
/~IRQ6: J1.103 (IRQ6), J4.4
/~IRQ7: J1.102 (IRQ7), J4.2
/~LINK: J3.3
/~RD: J3.20, U3.16 (IO4)
/~RESET: J1.115 (RESET), J3.17
/~RX: J3.5, U5.11 (2A3)
/~SPD: J3.8, U6.4 (1A1)
/~STS: U3.18 (IO2), U6.19 (2OE)
/~TX: J3.4, U6.2 (1A0)
GND: C1.2, C2.2, C3.2, C4.2, C5.2, C6.2, C7.2, C8.2, C9.2, C10.2, J1.1 (GND), J1.2 (GND), J1.3 (GND), J1.4 (GND), J1.5 (GND), J1.116 (GND), J1.117 (GND), J1.118 (GND), J1.119 (GND), J1.120 (GND), J1.121, J1.122, J2.18, J3.10, J3.15, J3.16, J3.23, J3.24, JP1.2, JP2.1, SW1.8, SW1.9, SW1.10, SW1.11, SW1.12, SW1.13, SW1.14, SW2.7, SW2.8, SW2.9, SW2.10, SW2.11, SW2.12, U1.10 (GND), U2.10 (GND), U3.10 (GND), U4.10 (GND), U5.1 (1OE), U5.10 (GND), U5.19 (2OE), U6.1 (1OE), U6.10 (GND)
unnamed: D1.1 (K), U5.9 (2Y3)
unnamed: D1.2 (A), R2.2
unnamed: D2.1 (K), U6.18 (1Y0)
unnamed: D2.2 (A), R3.2
unnamed: D3.1 (K), U6.16 (1Y1)
unnamed: D3.2 (A), R4.2
unnamed: D4.1 (K), U6.14 (1Y2)
unnamed: D4.2 (A), R5.2
unnamed: D5.1 (K), U6.12 (1Y3)
unnamed: D5.2 (A), R6.2
unnamed: J4.1, J4.3, J4.5, J4.7, J4.9, J4.11, J4.13, J4.15, U4.12 (IO8)
unnamed: JP2.2, U3.3 (I3)
unnamed: SW1.1, U1.1 (I1/CLK)
unnamed: SW1.2, U1.2 (I2)
unnamed: SW1.3, U1.3 (I3)
unnamed: SW1.4, U1.4 (I4)
unnamed: SW1.5, U1.5 (I5)
unnamed: SW1.6, U1.6 (I6)
unnamed: SW1.7, U1.7 (I7)
unnamed: SW2.1, U2.1 (I1/CLK)
unnamed: SW2.2, U2.2 (I2)
unnamed: SW2.3, U2.3 (I3)
unnamed: SW2.4, U2.4 (I4)
unnamed: SW2.5, U2.5 (I5)
unnamed: SW2.6, U2.6 (I6)
unnamed: U1.16 (IO4), U3.1 (I1/CLK)

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
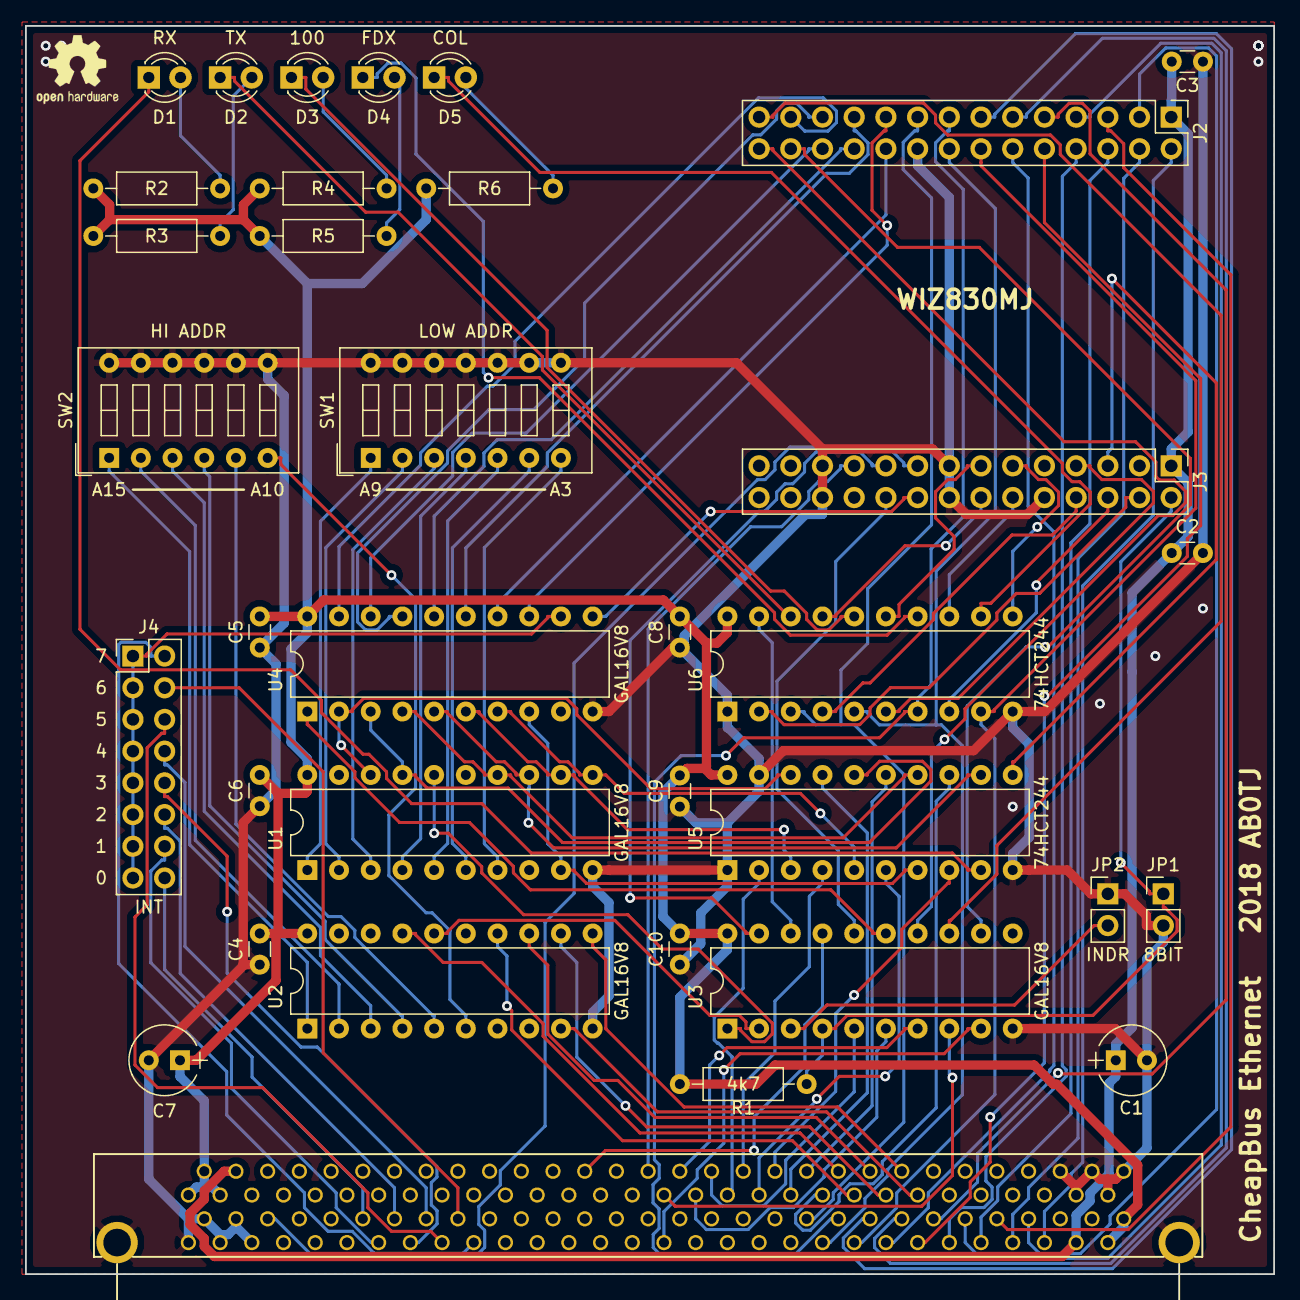
[picture p17: board Ethernet.kicad_pcb from above]

Board: 2 copper layers, 100.0 x 100.0 mm, 35 parts (0 on the bottom side), 107 nets.
