ab0tj/MiniSys/Boards/PPR Board/PPR Board.kicad_pcb

## KiCad design Boards/PPR Board/PPR Board.kicad_pcb (2020-03-27)

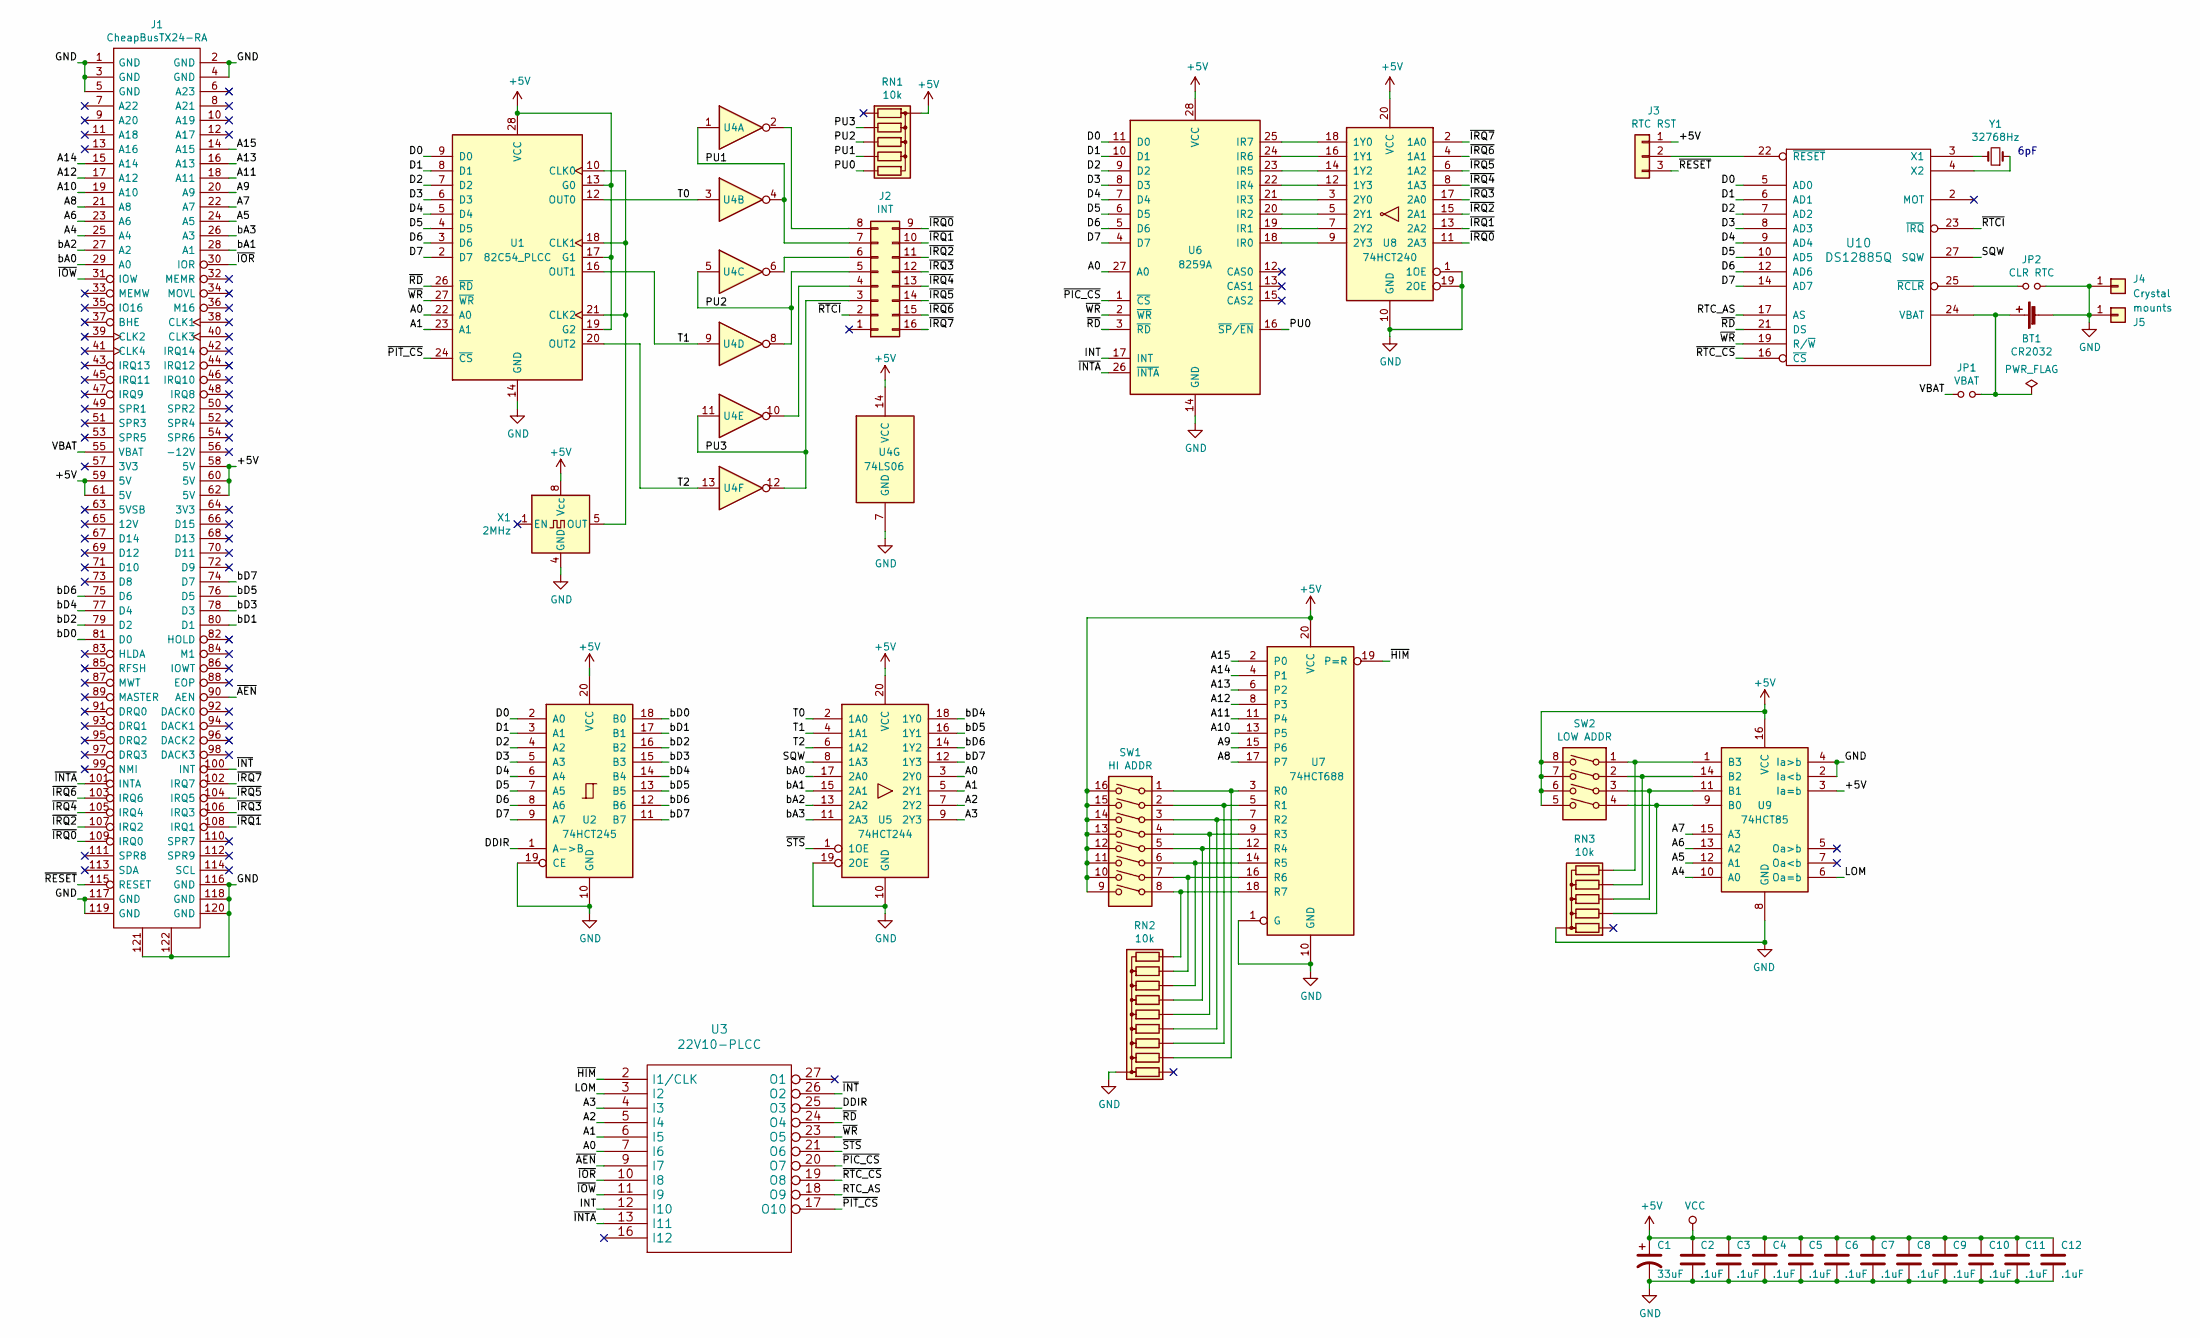
[picture p22: schematic PPR Board.sch]

Parts:
BT1: CR2032; BatteryHolder_Keystone_103_1x20mm
C1: 33uF; CP_Tantalum_Case-B_EIA-3528-21_Hand
C2, C3, C4, C5, C6, C7, C8, C9, C10, C11, C12: .1uF; C_0805_HandSoldering
J1: CheapBusTX24-RA; JAE_TX24-120R-LT-H1E; Mouser Part Number 656-TX24120RLTH1E
J2: INT; DIP-16_W7.62mm
J3: RTC RST; Pin_Header_Straight_1x03_Pitch2.54mm
J4: Crystal; Pin_Header_Straight_1x01_Pitch1.00mm
J5: mounts; Pin_Header_Straight_1x01_Pitch1.00mm
JP1: VBAT; Pin_Header_Straight_1x02_Pitch2.54mm
JP2: CLR RTC; Pin_Header_Straight_1x02_Pitch2.54mm
RN1, RN3: 10k; R_Array_SIP6
RN2: 10k; R_Array_SIP10
SW1: HI ADDR; SW_DIP_x8_W7.62mm_Slide
SW2: LOW ADDR; SW_DIP_x4_W7.62mm_Slide
U1: 82C54_PLCC; PLCC28
U2: 74HCT245; SOIC-20W_7.5x12.8mm_Pitch1.27mm
U3: 22V10-PLCC; PLCC28
U4: 74LS06; SOIC-14_3.9x8.7mm_Pitch1.27mm
U5: 74HCT244; SOIC-20W_7.5x12.8mm_Pitch1.27mm
U6: 8259A; PLCC28
U7: 74HCT688; SOIC-20W_7.5x12.8mm_Pitch1.27mm
U8: 74HCT240; SOIC-20W_7.5x12.8mm_Pitch1.27mm
U9: 74HCT85; SOIC-16_3.9x9.9mm_Pitch1.27mm
U10: DS12885Q; PLCC28
X1: 2MHz; Oscillator_DIP-8
Y1: 32768Hz; Crystal_C26-LF_d2.1mm_l6.5mm_Horizontal

Connections:
+5V: C1.1, C2.1, C3.1, C4.1, C5.1, C6.1, C7.1, C8.1, C9.1, C10.1, C11.1, C12.1, J1.58 (5V), J1.59 (5V), J1.60 (5V), J1.61 (5V), J1.62 (5V), J3.1, RN1.1 (common), SW1.9, SW1.10, SW1.11, SW1.12, SW1.13, SW1.14, SW1.15, SW1.16, SW2.5, SW2.6, SW2.7, SW2.8, U1.13 (G0), U1.17 (G1), U1.19 (G2), U1.28 (VCC), U2.20 (VCC), U3.1 (VCC), U3.28 (VCC), U4.14 (VCC), U5.20 (VCC), U6.28 (VCC), U7.20 (VCC), U8.20 (VCC), U9.3 (Ia=b), U9.16 (VCC), U10.28 (VCC), X1.8 (Vcc)
/A0: U1.22 (A0), U3.7 (I6), U5.3 (2Y0), U6.27 (A0)
/A1: U1.23 (A1), U3.6 (I5), U5.5 (2Y1)
/A2: U3.5 (I4), U5.7 (2Y2)
/A3: U3.4 (I3), U5.9 (2Y3)
/A4: J1.25 (A4), U9.10 (A0)
/A5: J1.24 (A5), U9.12 (A1)
/A6: J1.23 (A6), U9.13 (A2)
/A7: J1.22 (A7), U9.15 (A3)
/A8: J1.21 (A8), U7.17 (P7)
/A9: J1.20 (A9), U7.15 (P6)
/A10: J1.19 (A10), U7.13 (P5)
/A11: J1.18 (A11), U7.11 (P4)
/A12: J1.17 (A12), U7.8 (P3)
/A13: J1.16 (A13), U7.6 (P2)
/A14: J1.15 (A14), U7.4 (P1)
/A15: J1.14 (A15), U7.2 (P0)
/D0: U1.9 (D0), U2.2 (A0), U6.11 (D0), U10.5 (AD0)
/D1: U1.8 (D1), U2.3 (A1), U6.10 (D1), U10.6 (AD1)
/D2: U1.7 (D2), U2.4 (A2), U6.9 (D2), U10.7 (AD2)
/D3: U1.6 (D3), U2.5 (A3), U6.8 (D3), U10.8 (AD3)
/D4: U1.5 (D4), U2.6 (A4), U6.7 (D4), U10.9 (AD4)
/D5: U1.4 (D5), U2.7 (A5), U6.6 (D5), U10.10 (AD5)
/D6: U1.3 (D6), U2.8 (A6), U6.5 (D6), U10.12 (AD6)
/D7: U1.2 (D7), U2.9 (A7), U6.4 (D7), U10.14 (AD7)
/DDIR: U2.1 (A->B), U3.25 (O3)
/INT: U3.12 (I10), U6.17 (INT)
/LOM: U3.3 (I2), U9.6 (Oa=b)
/PU0: RN1.6 (R5), U6.16 (~SP~/~EN~)
/PU1: J2.7, RN1.5 (R4), U4.1, U4.4
/PU2: J2.5, RN1.4 (R3), U4.5, U4.8
/PU3: J2.3, RN1.3 (R2), U4.11, U4.12
/RTC_AS: U3.18 (O9), U10.17 (AS)
/SQW: U5.8 (1A3), U10.27 (SQW)
/T0: U1.12 (OUT0), U4.3, U5.2 (1A0)
/T1: U1.16 (OUT1), U4.9, U5.4 (1A1)
/T2: U1.20 (OUT2), U4.13, U5.6 (1A2)
/VBAT: J1.55 (VBAT), JP1.2
/bA0: J1.29 (A0), U5.17 (2A0)
/bA1: J1.28 (A1), U5.15 (2A1)
/bA2: J1.27 (A2), U5.13 (2A2)
/bA3: J1.26 (A3), U5.11 (2A3)
/bD0: J1.81 (D0), U2.18 (B0)
/bD1: J1.80 (D1), U2.17 (B1)
/bD2: J1.79 (D2), U2.16 (B2)
/bD3: J1.78 (D3), U2.15 (B3)
/bD4: J1.77 (D4), U2.14 (B4), U5.18 (1Y0)
/bD5: J1.76 (D5), U2.13 (B5), U5.16 (1Y1)
/bD6: J1.75 (D6), U2.12 (B6), U5.14 (1Y2)
/bD7: J1.74 (D7), U2.11 (B7), U5.12 (1Y3)
/~AEN: J1.90 (AEN), U3.9 (I7)
/~HIM: U3.2 (I1/CLK), U7.19 (P=R)
/~INT: J1.100 (INT), U3.26 (O2)
/~IOR: J1.30 (IOR), U3.10 (I8)
/~IOW: J1.31 (IOW), U3.11 (I9)
/~IRQ0: J1.109 (IRQ0), J2.9, U8.11 (2A3)
/~IRQ1: J1.108 (IRQ1), J2.10, U8.13 (2A2)
/~IRQ2: J1.107 (IRQ2), J2.11, U8.15 (2A1)
/~IRQ3: J1.106 (IRQ3), J2.12, U8.17 (2A0)
/~IRQ4: J1.105 (IRQ4), J2.13, U8.8 (1A3)
/~IRQ5: J1.104 (IRQ5), J2.14, U8.6 (1A2)
/~IRQ6: J1.103 (IRQ6), J2.15, U8.4 (1A1)
/~IRQ7: J1.102 (IRQ7), J2.16, U8.2 (1A0)
/~PIC_CS: U3.20 (O7), U6.1 (~CS~)
/~PIT_CS: U1.24 (~CS~), U3.17 (O10)
/~RESET: J1.115 (RESET), J3.3
/~RTCI: J2.2, U10.23 (~IRQ)
/~RTC_CS: U3.19 (O8), U10.16 (~CS)
/~STS: U3.21 (O6), U5.1 (1OE)
GND: BT1.2 (-), C1.2, C2.2, C3.2, C4.2, C5.2, C6.2, C7.2, C8.2, C9.2, C10.2, C11.2, C12.2, J1.1 (GND), J1.2 (GND), J1.3 (GND), J1.4 (GND), J1.5 (GND), J1.116 (GND), J1.117 (GND), J1.118 (GND), J1.119 (GND), J1.120 (GND), J1.121, J1.122, J4.1, J5.1, JP2.2, RN2.1 (common), RN3.1 (common), U1.14 (GND), U2.10 (GND), U2.19 (CE), U3.8 (GND), U3.14 (GND), U3.15 (GND), U3.22 (GND), U4.7 (GND), U5.10 (GND), U5.19 (2OE), U6.14 (GND), U7.1 (G), U7.10 (GND), U8.1 (1OE), U8.10 (GND), U8.19 (2OE), U9.2 (Ia<b), U9.4 (Ia>b), U9.8 (GND), U10.15 (GND), U10.20 (GND), X1.4 (GND)
unnamed: BT1.1 (+), JP1.1, U10.24 (VBAT)
unnamed: J2.4, U4.10
unnamed: J2.6, U4.6
unnamed: J2.8, U4.2
unnamed: J3.2, U10.22 (~RESET)
unnamed: JP2.1, U10.25 (~RCLR)
unnamed: RN2.3 (R2), SW1.1, U7.3 (R0)
unnamed: RN2.4 (R3), SW1.2, U7.5 (R1)
unnamed: RN2.5 (R4), SW1.3, U7.7 (R2)
unnamed: RN2.6 (R5), SW1.4, U7.9 (R3)
unnamed: RN2.7 (R6), SW1.5, U7.12 (R4)
unnamed: RN2.8 (R7), SW1.6, U7.14 (R5)
unnamed: RN2.9 (R8), SW1.7, U7.16 (R6)
unnamed: RN2.10 (R9), SW1.8, U7.18 (R7)
unnamed: RN3.3 (R2), SW2.4, U9.9 (B0)
unnamed: RN3.4 (R3), SW2.3, U9.11 (B1)
unnamed: RN3.5 (R4), SW2.2, U9.14 (B2)
unnamed: RN3.6 (R5), SW2.1, U9.1 (B3)
unnamed: U1.10 (CLK0), U1.18 (CLK1), U1.21 (CLK2), X1.5 (OUT)
unnamed: U6.18 (IR0), U8.9 (2Y3)
unnamed: U6.19 (IR1), U8.7 (2Y2)
unnamed: U6.20 (IR2), U8.5 (2Y1)
unnamed: U6.21 (IR3), U8.3 (2Y0)
unnamed: U6.22 (IR4), U8.12 (1Y3)
unnamed: U6.23 (IR5), U8.14 (1Y2)
unnamed: U6.24 (IR6), U8.16 (1Y1)
unnamed: U6.25 (IR7), U8.18 (1Y0)
unnamed: U10.3 (X1), Y1.2
unnamed: U10.4 (X2), Y1.1

Notes on the sheet:
6pF

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
