ab0tj/MiniSys/Boards/PPR Board/PPR Board.kicad_pcb

## KiCad design Boards/PPR Board/PPR Board.kicad_pcb (continued)

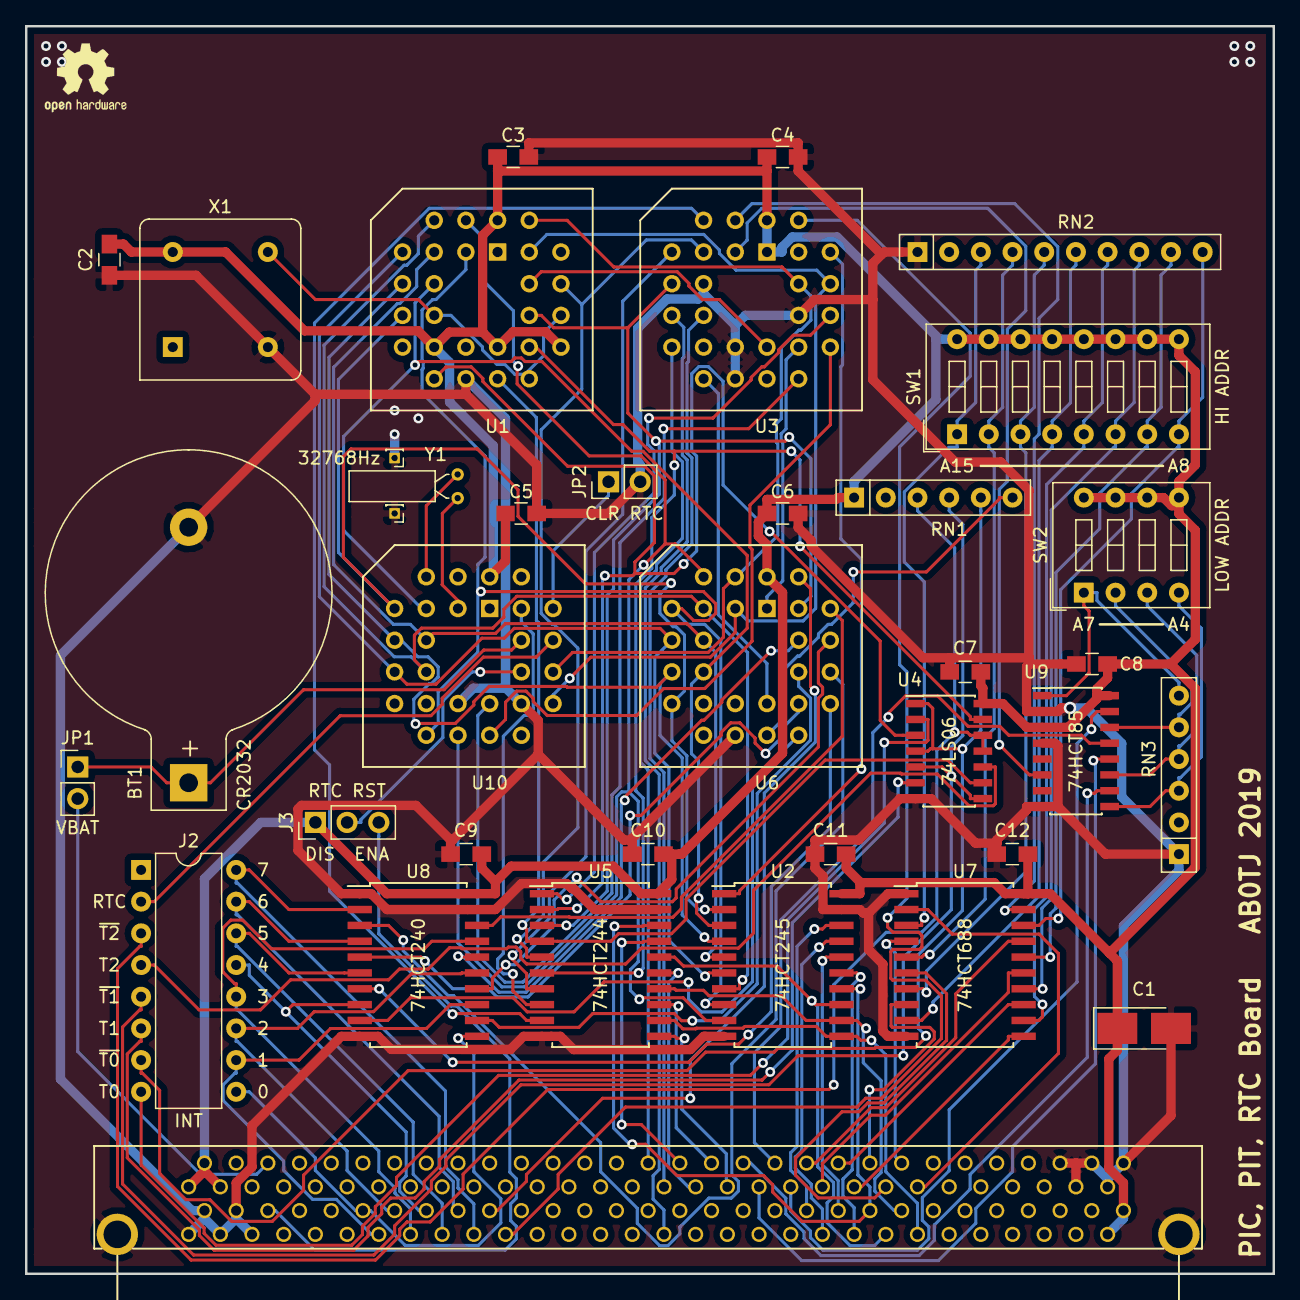
[picture p23: board PPR Board.kicad_pcb from above]

Board: 2 copper layers, 100.0 x 100.0 mm, 37 parts (0 on the bottom side), 102 nets.
