ab0tj/MiniSys/Boards/Breakout/MiniSys-Breakout.kicad_pcb

## KiCad design Boards/Breakout/MiniSys-Breakout.kicad_pcb (2020-03-27)

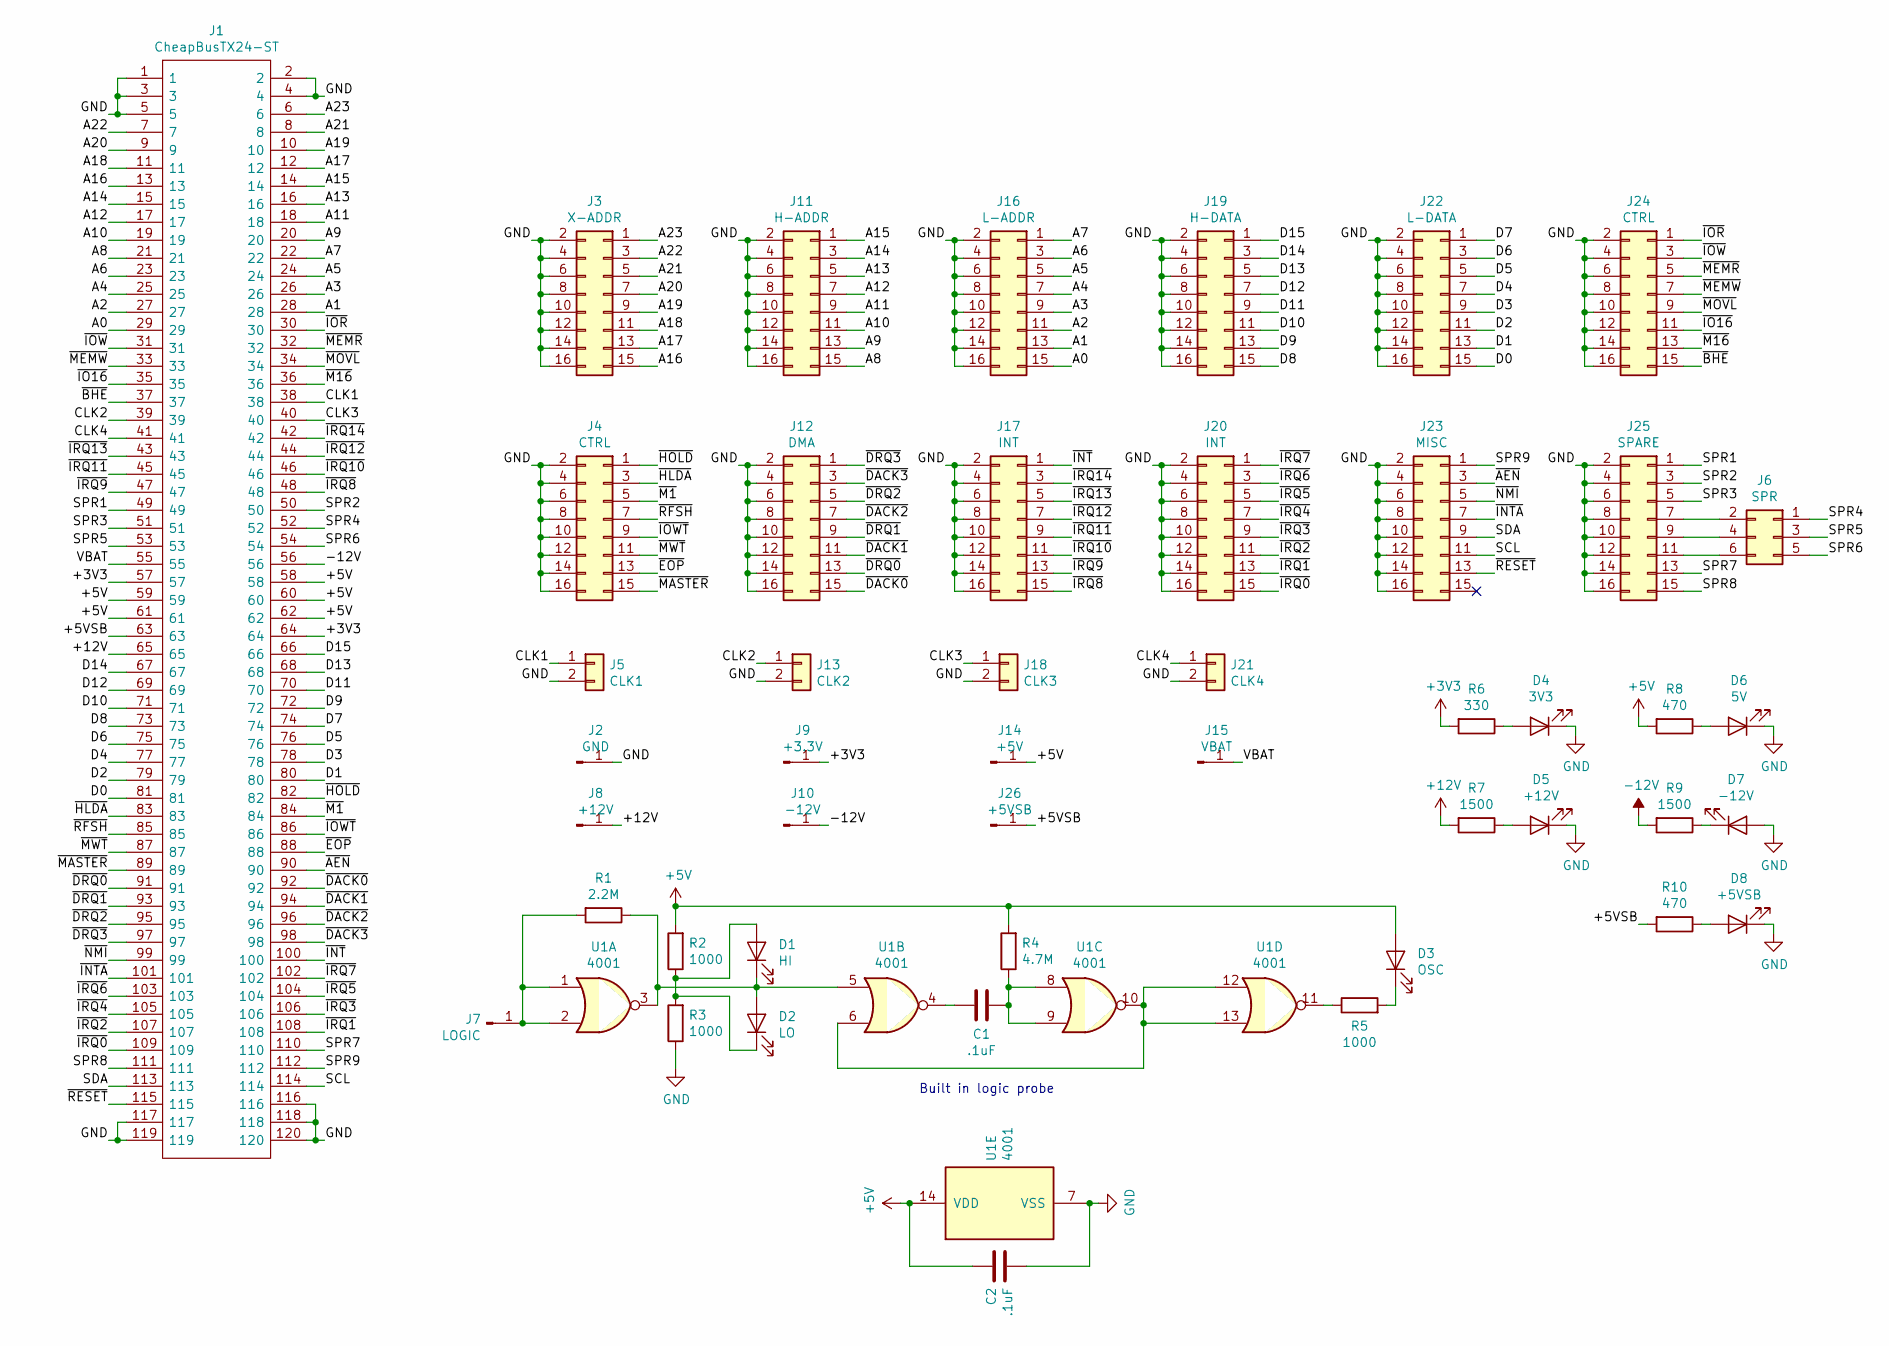
[picture p26: schematic MiniSys-Breakout.sch]

Parts:
C1, C2: .1uF; C_Disc_D5.0mm_W2.5mm_P5.00mm
D1: HI; LED_D5.0mm
D2: LO; LED_D5.0mm
D3: OSC; LED_D5.0mm
D4: 3V3; LED_D5.0mm
D5: +12V; LED_D5.0mm
D6: 5V; LED_D5.0mm
D7: -12V; LED_D5.0mm
D8: +5VSB; LED_D5.0mm
J1: CheapBusTX24-ST; JAE_TX24-120R-6ST-H1E; Mouser Part Number 656-TX24120RLTH1E
J2: GND; Pin_Header_Straight_1x01_Pitch2.54mm
J3: X-ADDR; Pin_Header_Straight_2x08_Pitch2.54mm
J4, J24: CTRL; Pin_Header_Straight_2x08_Pitch2.54mm
J5: CLK1; Pin_Header_Straight_1x02_Pitch2.54mm
J6: SPR; Pin_Header_Straight_2x03_Pitch2.54mm
J7: LOGIC; Pin_Header_Straight_1x01_Pitch2.54mm
J8: +12V; Pin_Header_Straight_1x01_Pitch2.54mm
J9: +3.3V; Pin_Header_Straight_1x01_Pitch2.54mm
J10: -12V; Pin_Header_Straight_1x01_Pitch2.54mm
J11: H-ADDR; Pin_Header_Straight_2x08_Pitch2.54mm
J12: DMA; Pin_Header_Straight_2x08_Pitch2.54mm
J13: CLK2; Pin_Header_Straight_1x02_Pitch2.54mm
J14: +5V; Pin_Header_Straight_1x01_Pitch2.54mm
J15: VBAT; Pin_Header_Straight_1x01_Pitch2.54mm
J16: L-ADDR; Pin_Header_Straight_2x08_Pitch2.54mm
J17, J20: INT; Pin_Header_Straight_2x08_Pitch2.54mm
J18: CLK3; Pin_Header_Straight_1x02_Pitch2.54mm
J19: H-DATA; Pin_Header_Straight_2x08_Pitch2.54mm
J21: CLK4; Pin_Header_Straight_1x02_Pitch2.54mm
J22: L-DATA; Pin_Header_Straight_2x08_Pitch2.54mm
J23: MISC; Pin_Header_Straight_2x08_Pitch2.54mm
J25: SPARE; Pin_Header_Straight_2x08_Pitch2.54mm
J26: +5VSB; Pin_Header_Straight_1x01_Pitch2.54mm
R1: 2.2M; R_Axial_DIN0207_L6.3mm_D2.5mm_P10.16mm_Horizontal
R2, R3, R5: 1000; R_Axial_DIN0207_L6.3mm_D2.5mm_P10.16mm_Horizontal
R4: 4.7M; R_Axial_DIN0207_L6.3mm_D2.5mm_P10.16mm_Horizontal
R6: 330; R_Axial_DIN0207_L6.3mm_D2.5mm_P10.16mm_Horizontal
R7, R9: 1500; R_Axial_DIN0207_L6.3mm_D2.5mm_P10.16mm_Horizontal
R8, R10: 470; R_Axial_DIN0207_L6.3mm_D2.5mm_P10.16mm_Horizontal
U1: 4001; DIP-14_W7.62mm

Connections:
+3V3: J1.57, J1.64, J9.1, R6.2
+5V: C2.1, D3.2 (A), J1.58, J1.59, J1.60, J1.61, J1.62, J14.1, R2.2, R4.2, R8.2, U1.14 (VDD)
+12V: J1.65, J8.1, R7.2
-12V: J1.56, J10.1, R9.2
/+5VSB: J1.63, J26.1, R10.2
/A0: J1.29, J16.15
/A1: J1.28, J16.13
/A2: J1.27, J16.11
/A3: J1.26, J16.9
/A4: J1.25, J16.7
/A5: J1.24, J16.5
/A6: J1.23, J16.3
/A7: J1.22, J16.1
/A8: J1.21, J11.15
/A9: J1.20, J11.13
/A10: J1.19, J11.11
/A11: J1.18, J11.9
/A12: J1.17, J11.7
/A13: J1.16, J11.5
/A14: J1.15, J11.3
/A15: J1.14, J11.1
/A16: J1.13, J3.15
/A17: J1.12, J3.13
/A18: J1.11, J3.11
/A19: J1.10, J3.9
/A20: J1.9, J3.7
/A21: J1.8, J3.5
/A22: J1.7, J3.3
/A23: J1.6, J3.1
/CLK1: J1.38, J5.1
/CLK2: J1.39, J13.1
/CLK3: J1.40, J18.1
/CLK4: J1.41, J21.1
/D0: J1.81, J22.15
/D1: J1.80, J22.13
/D2: J1.79, J22.11
/D3: J1.78, J22.9
/D4: J1.77, J22.7
/D5: J1.76, J22.5
/D6: J1.75, J22.3
/D7: J1.74, J22.1
/D8: J1.73, J19.15
/D9: J1.72, J19.13
/D10: J1.71, J19.11
/D11: J1.70, J19.9
/D12: J1.69, J19.7
/D13: J1.68, J19.5
/D14: J1.67, J19.3
/D15: J1.66, J19.1
/SCL: J1.114, J23.11
/SDA: J1.113, J23.9
/SPR1: J1.49, J25.1
/SPR2: J1.50, J25.3
/SPR3: J1.51, J25.5
/SPR4: J1.52, J6.1
/SPR5: J1.53, J6.3
/SPR6: J1.54, J6.5
/SPR7: J1.110, J25.13
/SPR8: J1.111, J25.15
/SPR9: J1.112, J23.1
/VBAT: J1.55, J15.1
/~AEN: J1.90, J23.3
/~BHE: J1.37, J24.15
/~DACK0: J1.92, J12.15
/~DACK1: J1.94, J12.11
/~DACK2: J1.96, J12.7
/~DACK3: J1.98, J12.3
/~DRQ0: J1.91, J12.13
/~DRQ1: J1.93, J12.9
/~DRQ2: J1.95, J12.5
/~DRQ3: J1.97, J12.1
/~EOP: J1.88, J4.13
/~HLDA: J1.83, J4.3
/~HOLD: J1.82, J4.1
/~INT: J1.100, J17.1
/~INTA: J1.101, J23.7
/~IO16: J1.35, J24.11
/~IOR: J1.30, J24.1
/~IOW: J1.31, J24.3
/~IOWT: J1.86, J4.9
/~IRQ0: J1.109, J20.15
/~IRQ1: J1.108, J20.13
/~IRQ2: J1.107, J20.11
/~IRQ3: J1.106, J20.9
/~IRQ4: J1.105, J20.7
/~IRQ5: J1.104, J20.5
/~IRQ6: J1.103, J20.3
/~IRQ7: J1.102, J20.1
/~IRQ8: J1.48, J17.15
/~IRQ9: J1.47, J17.13
/~IRQ10: J1.46, J17.11
/~IRQ11: J1.45, J17.9
/~IRQ12: J1.44, J17.7
/~IRQ13: J1.43, J17.5
/~IRQ14: J1.42, J17.3
/~M1: J1.84, J4.5
/~M16: J1.36, J24.13
/~MASTER: J1.89, J4.15
/~MEMR: J1.32, J24.5
/~MEMW: J1.33, J24.7
/~MOVL: J1.34, J24.9
/~MWT: J1.87, J4.11
/~NMI: J1.99, J23.5
/~RESET: J1.115, J23.13
/~RFSH: J1.85, J4.7
GND: C2.2, D4.1 (K), D5.1 (K), D6.1 (K), D7.2 (A), D8.1 (K), J1.1, J1.2, J1.3, J1.4, J1.5, J1.116, J1.117, J1.118, J1.119, J1.120, J2.1, J3.2, J3.4, J3.6, J3.8, J3.10, J3.12, J3.14, J3.16, J4.2, J4.4, J4.6, J4.8, J4.10, J4.12, J4.14, J4.16, J5.2, J11.2, J11.4, J11.6, J11.8, J11.10, J11.12, J11.14, J11.16, J12.2, J12.4, J12.6, J12.8, J12.10, J12.12, J12.14, J12.16, J13.2, J16.2, J16.4, J16.6, J16.8, J16.10, J16.12, J16.14, J16.16, J17.2, J17.4, J17.6, J17.8, J17.10, J17.12, J17.14, J17.16, J18.2, J19.2, J19.4, J19.6, J19.8, J19.10, J19.12, J19.14, J19.16, J20.2, J20.4, J20.6, J20.8, J20.10, J20.12, J20.14, J20.16, J21.2, J22.2, J22.4, J22.6, J22.8, J22.10, J22.12, J22.14, J22.16, J23.2, J23.4, J23.6, J23.8, J23.10, J23.12, J23.14, J23.16, J24.2, J24.4, J24.6, J24.8, J24.10, J24.12, J24.14, J24.16, J25.2, J25.4, J25.6, J25.8, J25.10, J25.12, J25.14, J25.16, R3.1, U1.7 (VSS)
unnamed: C1.1, R4.1, U1.8, U1.9
unnamed: C1.2, U1.4
unnamed: D1.1 (K), D2.2 (A), R1.1, U1.3, U1.5
unnamed: D1.2 (A), D2.1 (K), R2.1, R3.2
unnamed: D3.1 (K), R5.2
unnamed: D4.2 (A), R6.1
unnamed: D5.2 (A), R7.1
unnamed: D6.2 (A), R8.1
unnamed: D7.1 (K), R9.1
unnamed: D8.2 (A), R10.1
unnamed: J7.1, R1.2, U1.1, U1.2
unnamed: J6.2, J25.7
unnamed: J6.4, J25.9
unnamed: J6.6, J25.11
unnamed: R5.1, U1.11
unnamed: U1.6, U1.10, U1.12, U1.13

Notes on the sheet:
Built in logic probe

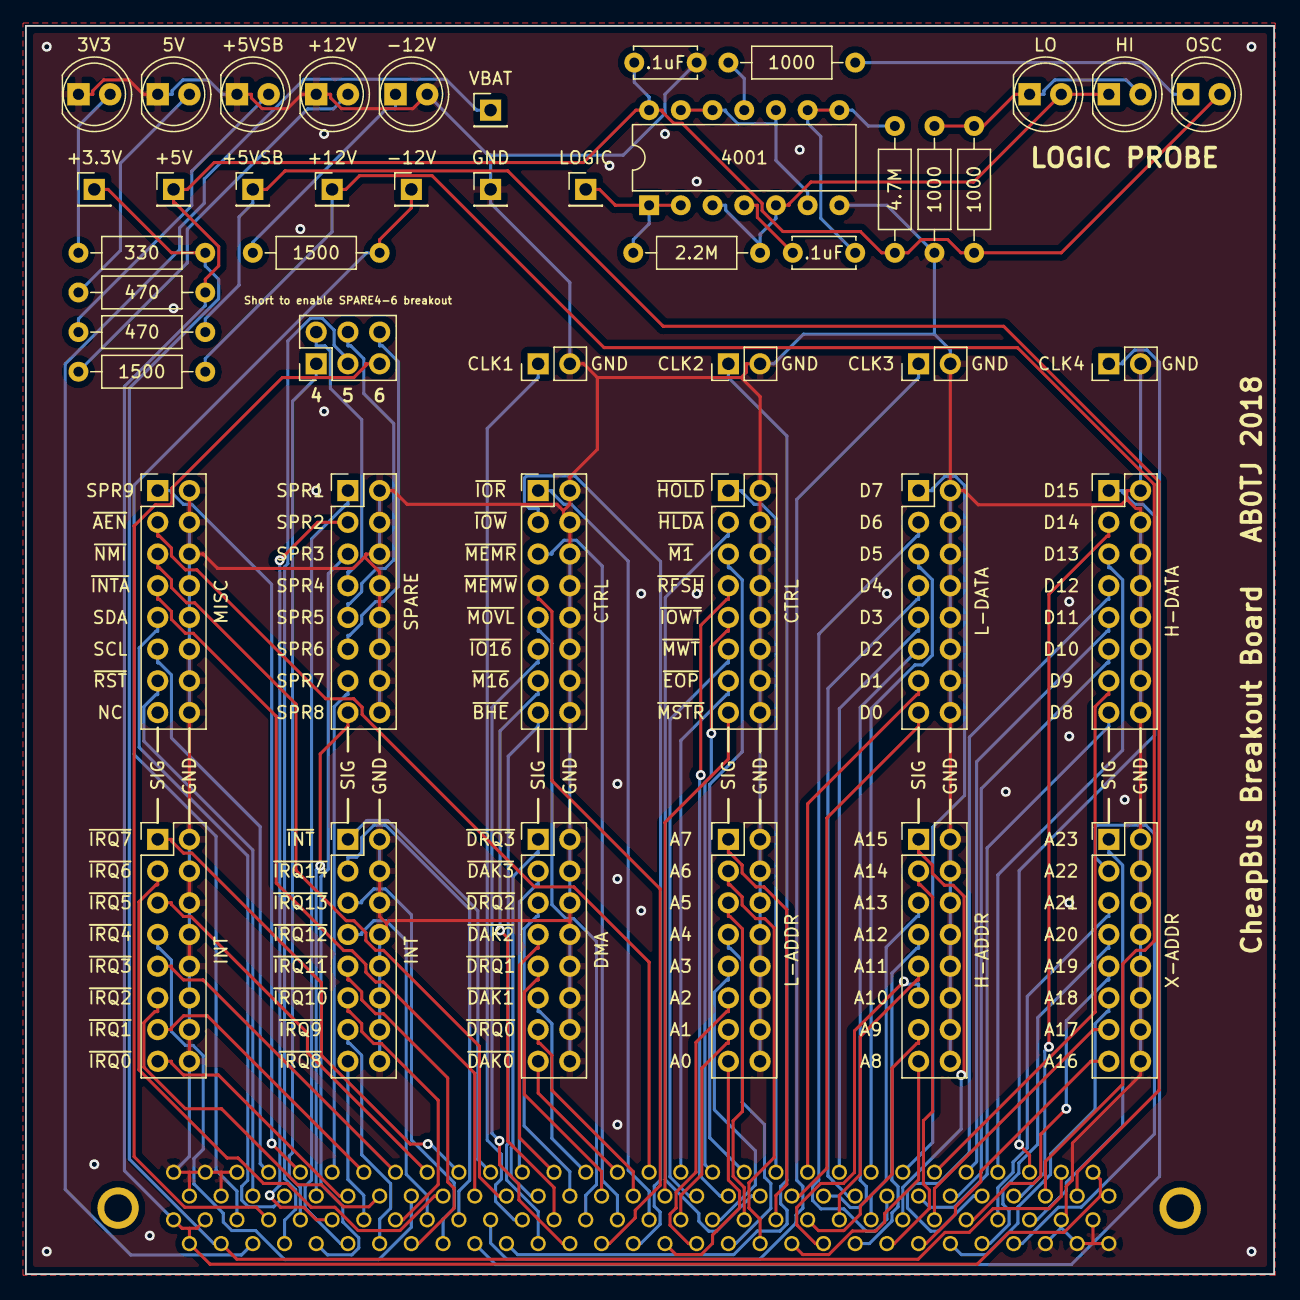
[picture p27: board MiniSys-Breakout.kicad_pcb from above]

Board: 2 copper layers, 100.0 x 100.0 mm, 47 parts (1 on the bottom side), 122 nets.
