ab0tj/MiniSys/Boards/16MB DRAM/16MB DRAM.kicad_pcb

## KiCad design Boards/16MB DRAM/16MB DRAM.kicad_pcb (2020-03-27)

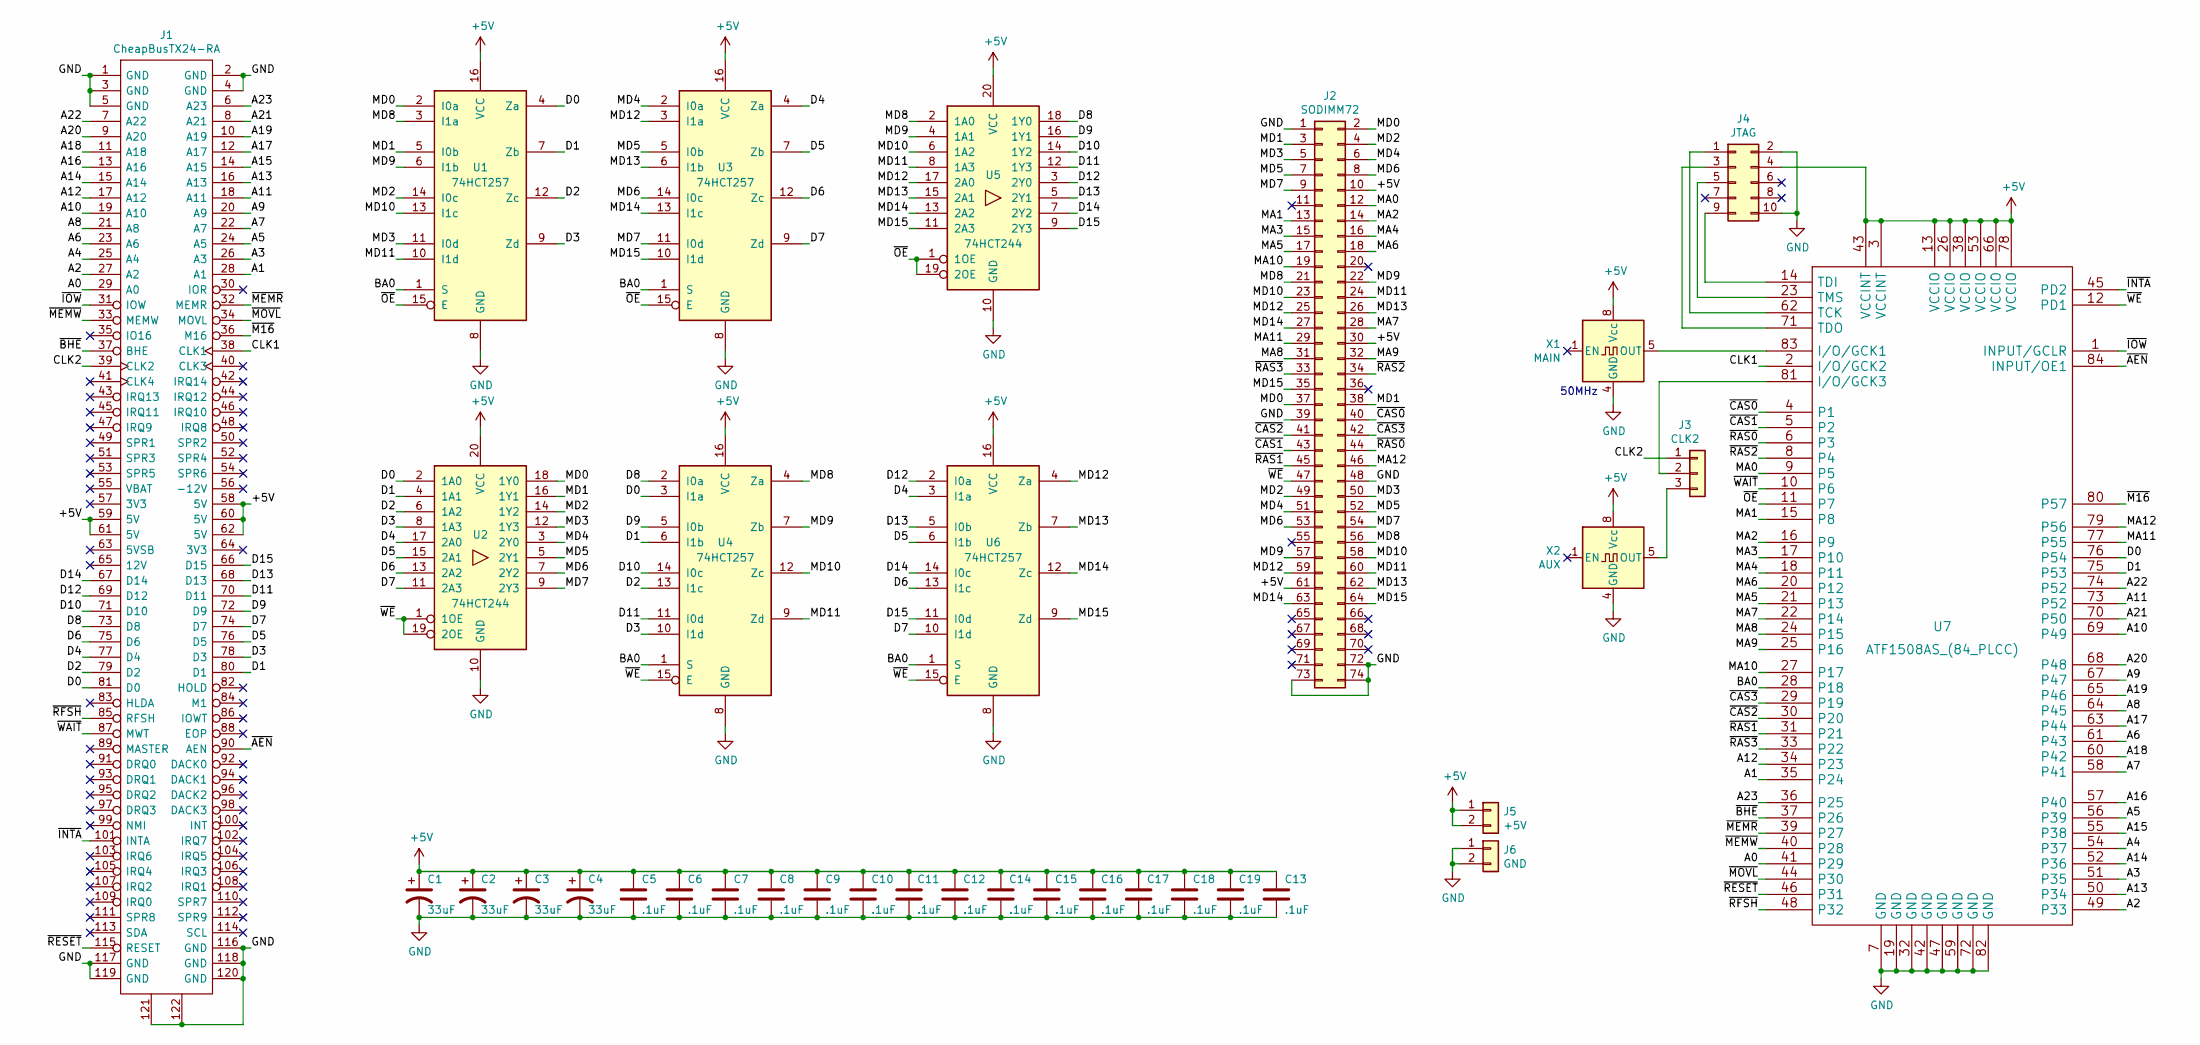
[picture p28: schematic 16MB DRAM.sch]

Parts:
C1, C2, C3, C4: 33uF; CP_Tantalum_Case-B_EIA-3528-21_Hand
C5, C6, C7, C8, C9, C10, C11, C12, C13, C14, C15, C16, C17, C18, C19: .1uF; C_0805_HandSoldering
J1: CheapBusTX24-RA; JAE_TX24-120R-LT-H1E; Mouser Part Number 656-TX24120RLTH1E
J2: SODIMM72; SODIMM-72
J3: CLK2; Pin_Header_Straight_1x03_Pitch2.54mm
J4: JTAG; Pin_Header_Straight_2x05_Pitch2.54mm
J5: +5V; Pin_Header_Straight_1x02_Pitch2.54mm
J6: GND; Pin_Header_Straight_1x02_Pitch2.54mm
U1, U3, U4, U6: 74HCT257; SOIC-16_3.9x9.9mm_Pitch1.27mm
U2, U5: 74HCT244; SOIC-20W_7.5x12.8mm_Pitch1.27mm
U7: ATF1508AS_(84_PLCC); PLCC84
X1: MAIN; Oscillator_DIP-8
X2: AUX; Oscillator_DIP-8

Connections:
+5V: C1.1, C2.1, C3.1, C4.1, C5.1, C6.1, C7.1, C8.1, C9.1, C10.1, C11.1, C12.1, C13.1, C14.1, C15.1, C16.1, C17.1, C18.1, C19.1, J1.58 (5V), J1.59 (5V), J1.60 (5V), J1.61 (5V), J1.62 (5V), J2.10, J2.30, J2.61, J4.4, J5.1, J5.2, U1.16 (VCC), U2.20 (VCC), U3.16 (VCC), U4.16 (VCC), U5.20 (VCC), U6.16 (VCC), U7.3 (VCCINT), U7.13 (VCCIO), U7.26 (VCCIO), U7.38 (VCCIO), U7.43 (VCCINT), U7.53 (VCCIO), U7.66 (VCCIO), U7.78 (VCCIO), X1.8 (Vcc), X2.8 (Vcc)
/A0: J1.29 (A0), U7.41 (P29)
/A1: J1.28 (A1), U7.35 (P24)
/A2: J1.27 (A2), U7.49 (P33)
/A3: J1.26 (A3), U7.51 (P35)
/A4: J1.25 (A4), U7.54 (P37)
/A5: J1.24 (A5), U7.56 (P39)
/A6: J1.23 (A6), U7.61 (P43)
/A7: J1.22 (A7), U7.58 (P41)
/A8: J1.21 (A8), U7.64 (P45)
/A9: J1.20 (A9), U7.67 (P47)
/A10: J1.19 (A10), U7.69 (P49)
/A11: J1.18 (A11), U7.73 (P52)
/A12: J1.17 (A12), U7.34 (P23)
/A13: J1.16 (A13), U7.50 (P34)
/A14: J1.15 (A14), U7.52 (P36)
/A15: J1.14 (A15), U7.55 (P38)
/A16: J1.13 (A16), U7.57 (P40)
/A17: J1.12 (A17), U7.63 (P44)
/A18: J1.11 (A18), U7.60 (P42)
/A19: J1.10 (A19), U7.65 (P46)
/A20: J1.9 (A20), U7.68 (P48)
/A21: J1.8 (A21), U7.70 (P50)
/A22: J1.7 (A22), U7.74 (P52)
/A23: J1.6 (A23), U7.36 (P25)
/BA0: U1.1 (S), U3.1 (S), U4.1 (S), U6.1 (S), U7.28 (P18)
/CLK1: J1.38 (CLK1), U7.2 (I/O/GCK2)
/CLK2: J1.39 (CLK2), J3.1
/D0: J1.81 (D0), U1.4 (Za), U2.2 (1A0), U4.3 (I1a), U7.76 (P54)
/D1: J1.80 (D1), U1.7 (Zb), U2.4 (1A1), U4.6 (I1b), U7.75 (P53)
/D2: J1.79 (D2), U1.12 (Zc), U2.6 (1A2), U4.13 (I1c)
/D3: J1.78 (D3), U1.9 (Zd), U2.8 (1A3), U4.10 (I1d)
/D4: J1.77 (D4), U2.17 (2A0), U3.4 (Za), U6.3 (I1a)
/D5: J1.76 (D5), U2.15 (2A1), U3.7 (Zb), U6.6 (I1b)
/D6: J1.75 (D6), U2.13 (2A2), U3.12 (Zc), U6.13 (I1c)
/D7: J1.74 (D7), U2.11 (2A3), U3.9 (Zd), U6.10 (I1d)
/D8: J1.73 (D8), U4.2 (I0a), U5.18 (1Y0)
/D9: J1.72 (D9), U4.5 (I0b), U5.16 (1Y1)
/D10: J1.71 (D10), U4.14 (I0c), U5.14 (1Y2)
/D11: J1.70 (D11), U4.11 (I0d), U5.12 (1Y3)
/D12: J1.69 (D12), U5.3 (2Y0), U6.2 (I0a)
/D13: J1.68 (D13), U5.5 (2Y1), U6.5 (I0b)
/D14: J1.67 (D14), U5.7 (2Y2), U6.14 (I0c)
/D15: J1.66 (D15), U5.9 (2Y3), U6.11 (I0d)
/MA0: J2.12, U7.9 (P5)
/MA1: J2.13, U7.15 (P8)
/MA2: J2.14, U7.16 (P9)
/MA3: J2.15, U7.17 (P10)
/MA4: J2.16, U7.18 (P11)
/MA5: J2.17, U7.21 (P13)
/MA6: J2.18, U7.20 (P12)
/MA7: J2.28, U7.22 (P14)
/MA8: J2.31, U7.24 (P15)
/MA9: J2.32, U7.25 (P16)
/MA10: J2.19, U7.27 (P17)
/MA11: J2.29, U7.77 (P55)
/MA12: J2.46, U7.79 (P56)
/MD0: J2.2, J2.37, U1.2 (I0a), U2.18 (1Y0)
/MD1: J2.3, J2.38, U1.5 (I0b), U2.16 (1Y1)
/MD2: J2.4, J2.49, U1.14 (I0c), U2.14 (1Y2)
/MD3: J2.5, J2.50, U1.11 (I0d), U2.12 (1Y3)
/MD4: J2.6, J2.51, U2.3 (2Y0), U3.2 (I0a)
/MD5: J2.7, J2.52, U2.5 (2Y1), U3.5 (I0b)
/MD6: J2.8, J2.53, U2.7 (2Y2), U3.14 (I0c)
/MD7: J2.9, J2.54, U2.9 (2Y3), U3.11 (I0d)
/MD8: J2.21, J2.56, U1.3 (I1a), U4.4 (Za), U5.2 (1A0)
/MD9: J2.22, J2.57, U1.6 (I1b), U4.7 (Zb), U5.4 (1A1)
/MD10: J2.23, J2.58, U1.13 (I1c), U4.12 (Zc), U5.6 (1A2)
/MD11: J2.24, J2.60, U1.10 (I1d), U4.9 (Zd), U5.8 (1A3)
/MD12: J2.25, J2.59, U3.3 (I1a), U5.17 (2A0), U6.4 (Za)
/MD13: J2.26, J2.62, U3.6 (I1b), U5.15 (2A1), U6.7 (Zb)
/MD14: J2.27, J2.63, U3.13 (I1c), U5.13 (2A2), U6.12 (Zc)
/MD15: J2.35, J2.64, U3.10 (I1d), U5.11 (2A3), U6.9 (Zd)
/~AEN: J1.90 (AEN), U7.84 (INPUT/OE1)
/~BHE: J1.37 (BHE), U7.37 (P26)
/~CAS0: J2.40, U7.4 (P1)
/~CAS1: J2.43, U7.5 (P2)
/~CAS2: J2.41, U7.30 (P20)
/~CAS3: J2.42, U7.29 (P19)
/~INTA: J1.101 (INTA), U7.45 (PD2)
/~IOW: J1.31 (IOW), U7.1 (INPUT/GCLR)
/~M16: J1.36 (M16), U7.80 (P57)
/~MEMR: J1.32 (MEMR), U7.39 (P27)
/~MEMW: J1.33 (MEMW), U7.40 (P28)
/~MOVL: J1.34 (MOVL), U7.44 (P30)
/~OE: U1.15 (E), U3.15 (E), U5.1 (1OE), U5.19 (2OE), U7.11 (P7)
/~RAS0: J2.44, U7.6 (P3)
/~RAS1: J2.45, U7.31 (P21)
/~RAS2: J2.34, U7.8 (P4)
/~RAS3: J2.33, U7.33 (P22)
/~RESET: J1.115 (RESET), U7.46 (P31)
/~RFSH: J1.85 (RFSH), U7.48 (P32)
/~WAIT: J1.87 (MWT), U7.10 (P6)
/~WE: J2.47, U2.1 (1OE), U2.19 (2OE), U4.15 (E), U6.15 (E), U7.12 (PD1)
GND: C1.2, C2.2, C3.2, C4.2, C5.2, C6.2, C7.2, C8.2, C9.2, C10.2, C11.2, C12.2, C13.2, C14.2, C15.2, C16.2, C17.2, C18.2, C19.2, J1.1 (GND), J1.2 (GND), J1.3 (GND), J1.4 (GND), J1.5 (GND), J1.116 (GND), J1.117 (GND), J1.118 (GND), J1.119 (GND), J1.120 (GND), J1.121, J1.122, J2.1, J2.39, J2.48, J2.72, J2.73, J2.74, J4.2, J4.10, J6.1, J6.2, U1.8 (GND), U2.10 (GND), U3.8 (GND), U4.8 (GND), U5.10 (GND), U6.8 (GND), U7.7 (GND), U7.19 (GND), U7.32 (GND), U7.42 (GND), U7.47 (GND), U7.59 (GND), U7.72 (GND), U7.82 (GND), X1.4 (GND), X2.4 (GND)
unnamed: J3.2, U7.81 (I/O/GCK3)
unnamed: J3.3, X2.5 (OUT)
unnamed: J4.1, U7.62 (TCK)
unnamed: J4.3, U7.71 (TDO)
unnamed: J4.5, U7.23 (TMS)
unnamed: J4.9, U7.14 (TDI)
unnamed: U7.83 (I/O/GCK1), X1.5 (OUT)

Notes on the sheet:
50MHz
