ab0tj/MiniSys/Boards/16MB DRAM/16MB DRAM.kicad_pcb

## KiCad design Boards/16MB DRAM/16MB DRAM.kicad_pcb (continued)

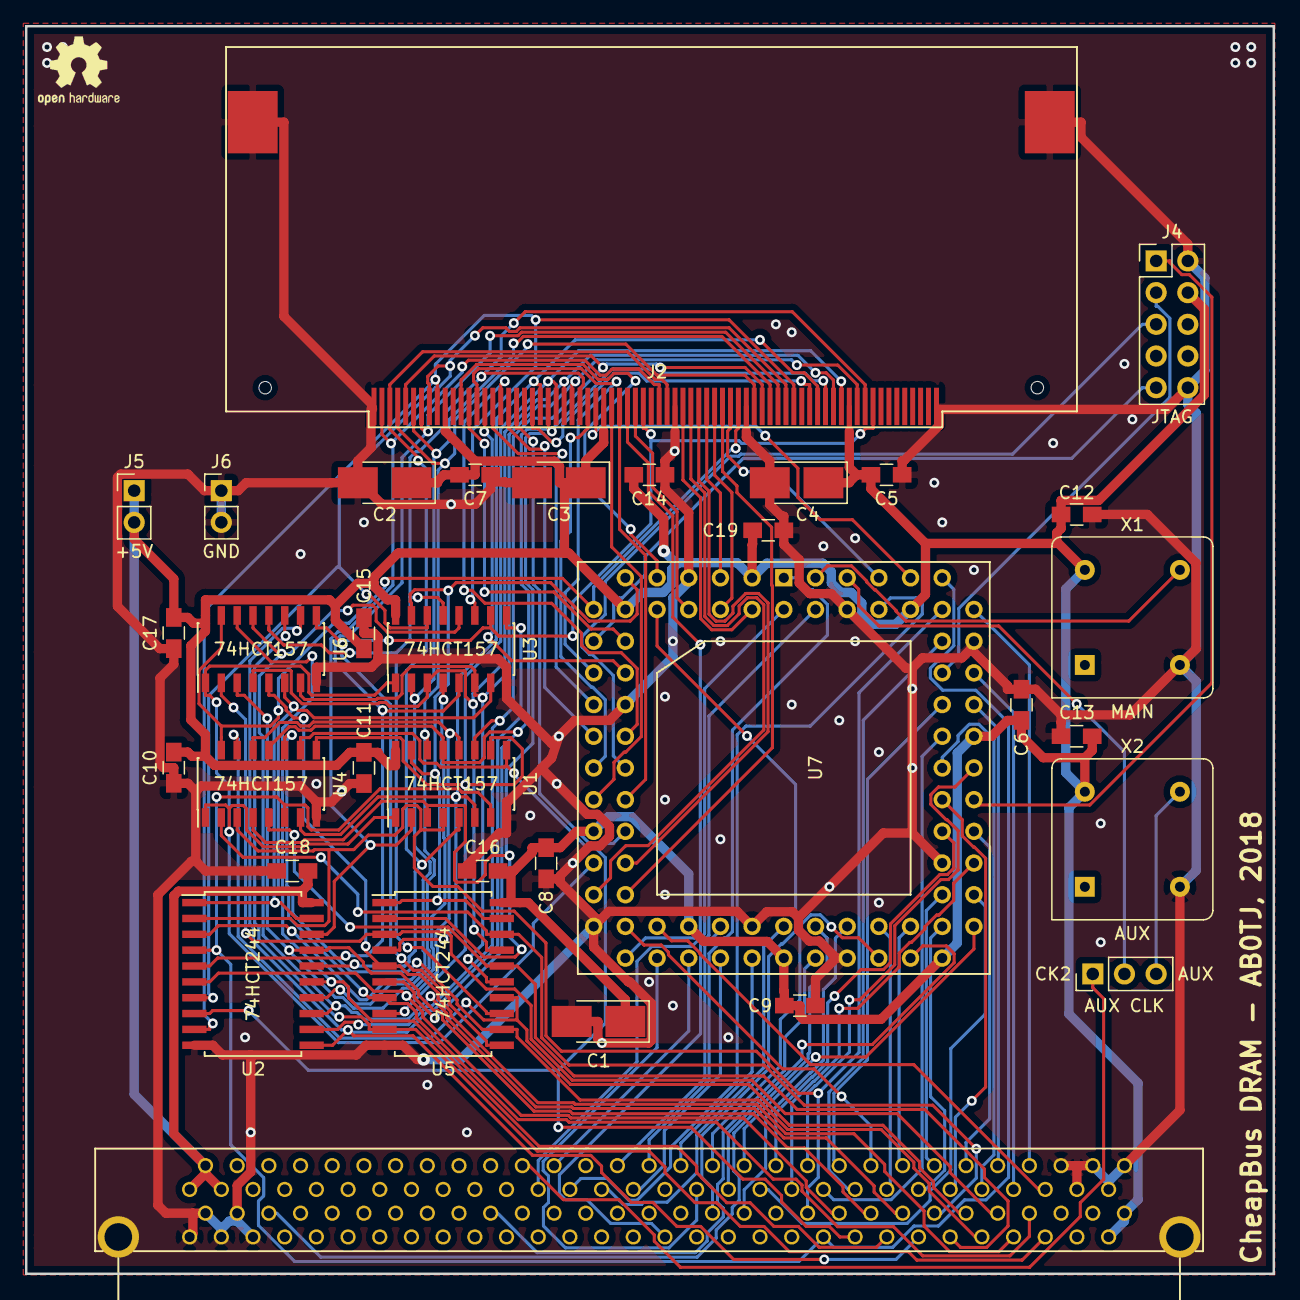
[picture p29: board 16MB DRAM.kicad_pcb from above]

Board: 2 copper layers, 100.0 x 100.0 mm, 34 parts (0 on the bottom side), 102 nets.
