ab0tj/MiniSys/Boards/Pi Board/Pi Board.kicad_pcb

## KiCad design Boards/Pi Board/Pi Board.kicad_pcb (2020-03-27)

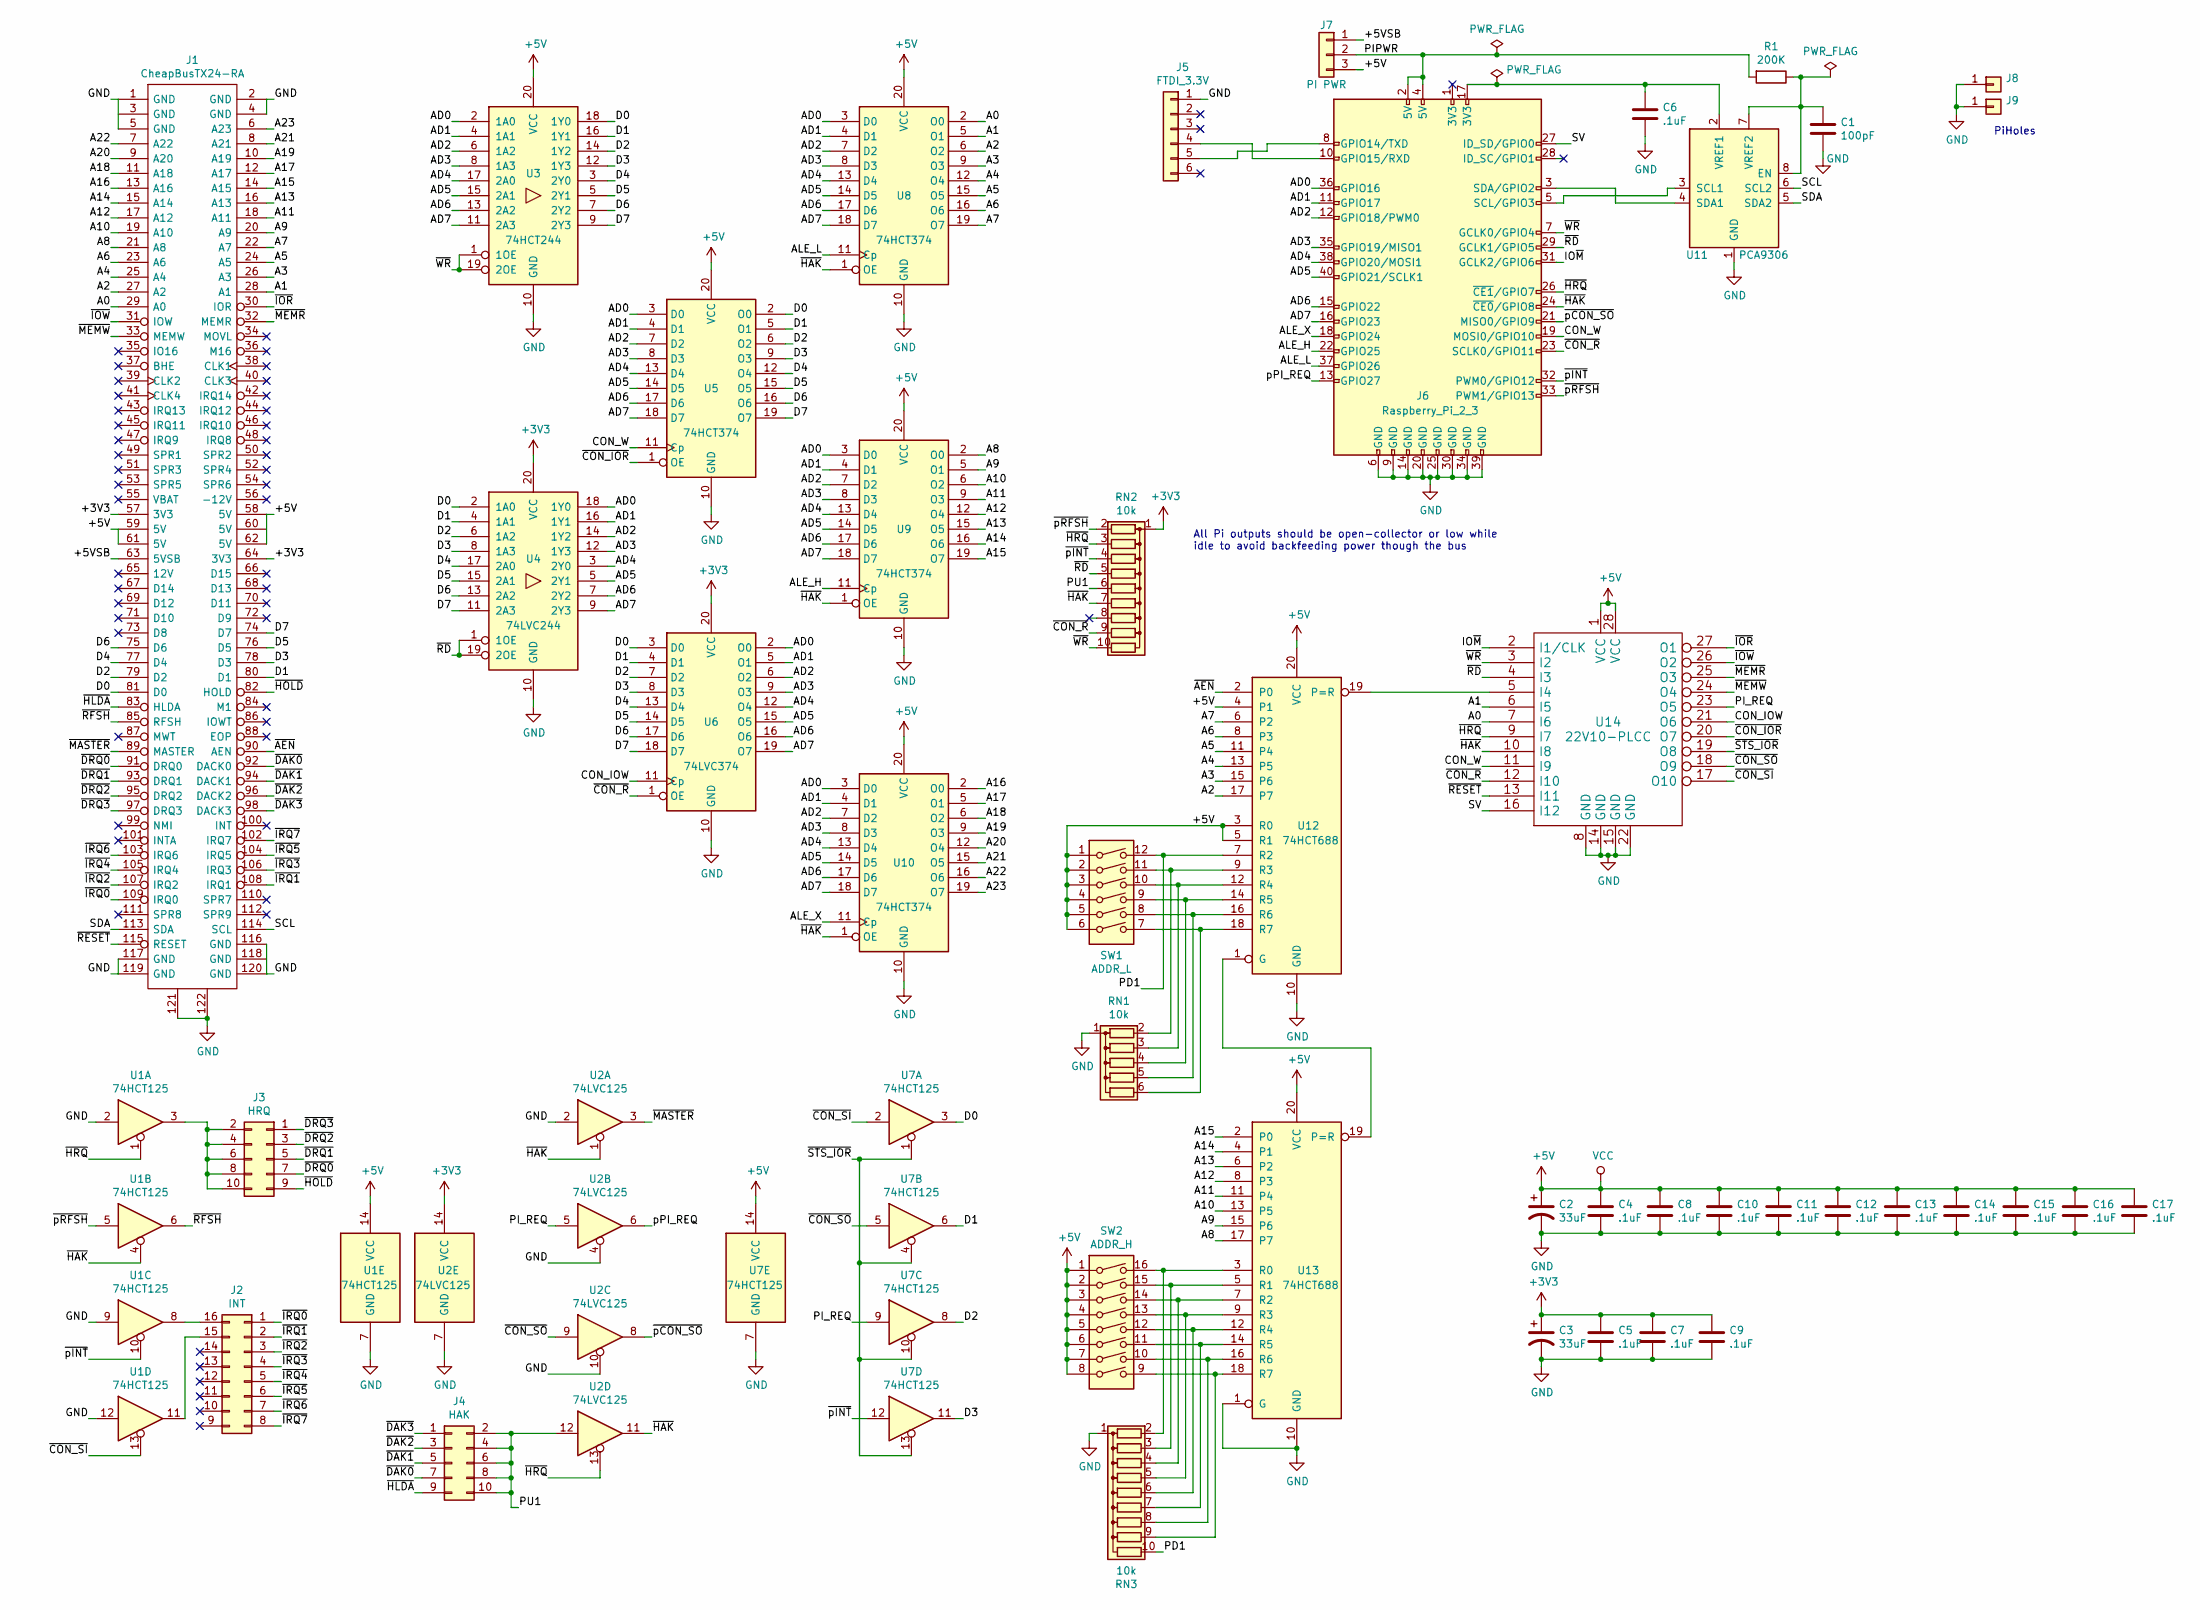
[picture p30: schematic Pi Board.sch]

Parts:
C1: 100pF; C_0805_HandSoldering
C2, C3: 33uF; CP_Tantalum_Case-B_EIA-3528-21_Hand
C4, C5, C6, C7, C8, C9, C10, C11, C12, C13, C14, C15, C16, C17: .1uF; C_0805_HandSoldering
J1: CheapBusTX24-RA; JAE_TX24-120R-LT-H1E; Mouser Part Number 656-TX24120RLTH1E
J2: INT; DIP-16_W7.62mm
J3: HRQ; Pin_Header_Straight_2x05_Pitch2.54mm
J4: HAK; Pin_Header_Straight_2x05_Pitch2.54mm
J5: FTDI_3.3V; Pin_Header_Angled_1x06_Pitch2.54mm
J6: Raspberry_Pi_2_3; Pin_Header_Straight_2x20_Pitch2.54mm
J7: PI PWR; Pin_Header_Straight_1x03_Pitch2.54mm
J8, J9: Conn_01x01; MountingHole_2.7mm_Pad_Via
R1: 200K; R_0805_HandSoldering
RN1: 10k; R_Array_SIP6
RN2, RN3: 10k; R_Array_SIP10
SW1: ADDR_L; SW_DIP_x6_W7.62mm_Slide
SW2: ADDR_H; SW_DIP_x8_W7.62mm_Slide
U1, U7: 74HCT125; SOIC-14_3.9x8.7mm_Pitch1.27mm
U2: 74LVC125; SOIC-14_3.9x8.7mm_Pitch1.27mm
U3: 74HCT244; SOIC-20W_7.5x12.8mm_Pitch1.27mm
U4: 74LVC244; SOIC-20W_7.5x12.8mm_Pitch1.27mm
U5, U8, U9, U10: 74HCT374; SOIC-20W_7.5x12.8mm_Pitch1.27mm
U6: 74LVC374; SOIC-20W_7.5x12.8mm_Pitch1.27mm
U11: PCA9306; SOIC-8_3.9x4.9mm_Pitch1.27mm
U12, U13: 74HCT688; SOIC-20W_7.5x12.8mm_Pitch1.27mm
U14: 22V10-PLCC; PLCC28

Connections:
+3V3: C3.1, C5.1, C7.1, C9.1, J1.57 (3V3), J1.64 (3V3), RN2.1 (common), U2.14 (VCC), U4.20 (VCC), U6.20 (VCC)
+5V: C2.1, C4.1, C8.1, C10.1, C11.1, C12.1, C13.1, C14.1, C15.1, C16.1, C17.1, J1.58 (5V), J1.59 (5V), J1.60 (5V), J1.61 (5V), J1.62 (5V), J7.3, SW1.1, SW1.2, SW1.3, SW1.4, SW1.5, SW1.6, SW2.1, SW2.2, SW2.3, SW2.4, SW2.5, SW2.6, SW2.7, SW2.8, U1.14 (VCC), U3.20 (VCC), U5.20 (VCC), U7.14 (VCC), U8.20 (VCC), U9.20 (VCC), U10.20 (VCC), U12.3 (R0), U12.4 (P1), U12.5 (R1), U12.20 (VCC), U13.20 (VCC), U14.1 (VCC), U14.28 (VCC)
/+5VSB: J1.63 (5VSB), J7.1
/A0: J1.29 (A0), U8.2 (O0), U14.7 (I6)
/A1: J1.28 (A1), U8.5 (O1), U14.6 (I5)
/A2: J1.27 (A2), U8.6 (O2), U12.17 (P7)
/A3: J1.26 (A3), U8.9 (O3), U12.15 (P6)
/A4: J1.25 (A4), U8.12 (O4), U12.13 (P5)
/A5: J1.24 (A5), U8.15 (O5), U12.11 (P4)
/A6: J1.23 (A6), U8.16 (O6), U12.8 (P3)
/A7: J1.22 (A7), U8.19 (O7), U12.6 (P2)
/A8: J1.21 (A8), U9.2 (O0), U13.17 (P7)
/A9: J1.20 (A9), U9.5 (O1), U13.15 (P6)
/A10: J1.19 (A10), U9.6 (O2), U13.13 (P5)
/A11: J1.18 (A11), U9.9 (O3), U13.11 (P4)
/A12: J1.17 (A12), U9.12 (O4), U13.8 (P3)
/A13: J1.16 (A13), U9.15 (O5), U13.6 (P2)
/A14: J1.15 (A14), U9.16 (O6), U13.4 (P1)
/A15: J1.14 (A15), U9.19 (O7), U13.2 (P0)
/A16: J1.13 (A16), U10.2 (O0)
/A17: J1.12 (A17), U10.5 (O1)
/A18: J1.11 (A18), U10.6 (O2)
/A19: J1.10 (A19), U10.9 (O3)
/A20: J1.9 (A20), U10.12 (O4)
/A21: J1.8 (A21), U10.15 (O5)
/A22: J1.7 (A22), U10.16 (O6)
/A23: J1.6 (A23), U10.19 (O7)
/AD0: J6.36 (GPIO16), U3.2 (1A0), U4.18 (1Y0), U5.3 (D0), U6.2 (O0), U8.3 (D0), U9.3 (D0), U10.3 (D0)
/AD1: J6.11 (GPIO17), U3.4 (1A1), U4.16 (1Y1), U5.4 (D1), U6.5 (O1), U8.4 (D1), U9.4 (D1), U10.4 (D1)
/AD2: J6.12 (GPIO18/PWM0), U3.6 (1A2), U4.14 (1Y2), U5.7 (D2), U6.6 (O2), U8.7 (D2), U9.7 (D2), U10.7 (D2)
/AD3: J6.35 (GPIO19/MISO1), U3.8 (1A3), U4.12 (1Y3), U5.8 (D3), U6.9 (O3), U8.8 (D3), U9.8 (D3), U10.8 (D3)
/AD4: J6.38 (GPIO20/MOSI1), U3.17 (2A0), U4.3 (2Y0), U5.13 (D4), U6.12 (O4), U8.13 (D4), U9.13 (D4), U10.13 (D4)
/AD5: J6.40 (GPIO21/SCLK1), U3.15 (2A1), U4.5 (2Y1), U5.14 (D5), U6.15 (O5), U8.14 (D5), U9.14 (D5), U10.14 (D5)
/AD6: J6.15 (GPIO22), U3.13 (2A2), U4.7 (2Y2), U5.17 (D6), U6.16 (O6), U8.17 (D6), U9.17 (D6), U10.17 (D6)
/AD7: J6.16 (GPIO23), U3.11 (2A3), U4.9 (2Y3), U5.18 (D7), U6.19 (O7), U8.18 (D7), U9.18 (D7), U10.18 (D7)
/ALE_H: J6.22 (GPIO25), U9.11 (Cp)
/ALE_L: J6.37 (GPIO26), U8.11 (Cp)
/ALE_X: J6.18 (GPIO24), U10.11 (Cp)
/CON_IOW: U6.11 (Cp), U14.21 (O6)
/CON_W: J6.19 (MOSI0/GPIO10), U5.11 (Cp), U14.11 (I9)
/D0: J1.81 (D0), U3.18 (1Y0), U4.2 (1A0), U5.2 (O0), U6.3 (D0), U7.3
/D1: J1.80 (D1), U3.16 (1Y1), U4.4 (1A1), U5.5 (O1), U6.4 (D1), U7.6
/D2: J1.79 (D2), U3.14 (1Y2), U4.6 (1A2), U5.6 (O2), U6.7 (D2), U7.8
/D3: J1.78 (D3), U3.12 (1Y3), U4.8 (1A3), U5.9 (O3), U6.8 (D3), U7.11
/D4: J1.77 (D4), U3.3 (2Y0), U4.17 (2A0), U5.12 (O4), U6.13 (D4)
/D5: J1.76 (D5), U3.5 (2Y1), U4.15 (2A1), U5.15 (O5), U6.14 (D5)
/D6: J1.75 (D6), U3.7 (2Y2), U4.13 (2A2), U5.16 (O6), U6.17 (D6)
/D7: J1.74 (D7), U3.9 (2Y3), U4.11 (2A3), U5.19 (O7), U6.18 (D7)
/IO~M: J6.31 (GCLK2/GPIO6), U14.2 (I1/CLK)
/PD1: RN3.10 (R9), SW1.12, U12.7 (R2)
/PIPWR: J6.2 (5V), J6.4 (5V), J7.2, R1.2
/PI_REQ: U2.5, U7.9, U14.23 (O5)
/PU1: J4.2, J4.4, J4.6, J4.8, J4.10, RN2.6 (R5), U2.12
/SCL: J1.114 (SCL), U11.6 (SCL2)
/SDA: J1.113 (SDA), U11.5 (SDA2)
/pPI_REQ: J6.13 (GPIO27), U2.6
/~AEN: J1.90 (AEN), U12.2 (P0)
/~CON_IOR: U5.1 (OE), U14.20 (O7)
/~CON_R: J6.23 (SCLK0/GPIO11), RN2.9 (R8), U6.1 (OE), U14.12 (I10)
/~CON_SI: U1.13, U7.2, U14.17 (O10)
/~CON_SO: U2.9, U7.5, U14.18 (O9)
/~DAK0: J1.92 (DACK0), J4.7
/~DAK1: J1.94 (DACK1), J4.5
/~DAK2: J1.96 (DACK2), J4.3
/~DAK3: J1.98 (DACK3), J4.1
/~DRQ0: J1.91 (DRQ0), J3.7
/~DRQ1: J1.93 (DRQ1), J3.5
/~DRQ2: J1.95 (DRQ2), J3.3
/~DRQ3: J1.97 (DRQ3), J3.1
/~HAK: J6.24 (~CE0~/GPIO8), RN2.7 (R6), U1.4, U2.1, U2.11, U8.1 (OE), U9.1 (OE), U10.1 (OE), U14.10 (I8)
/~HLDA: J1.83 (HLDA), J4.9
/~HOLD: J1.82 (HOLD), J3.9
/~HRQ: J6.26 (~CE1~/GPIO7), RN2.3 (R2), U1.1, U2.13, U14.9 (I7)
/~IOR: J1.30 (IOR), U14.27 (O1)
/~IOW: J1.31 (IOW), U14.26 (O2)
/~IRQ0: J1.109 (IRQ0), J2.1
/~IRQ1: J1.108 (IRQ1), J2.2
/~IRQ2: J1.107 (IRQ2), J2.3
/~IRQ3: J1.106 (IRQ3), J2.4
/~IRQ4: J1.105 (IRQ4), J2.5
/~IRQ5: J1.104 (IRQ5), J2.6
/~IRQ6: J1.103 (IRQ6), J2.7
/~IRQ7: J1.102 (IRQ7), J2.8
/~MASTER: J1.89 (MASTER), U2.3
/~MEMR: J1.32 (MEMR), U14.25 (O3)
/~MEMW: J1.33 (MEMW), U14.24 (O4)
/~RD: J6.29 (GCLK1/GPIO5), RN2.5 (R4), U4.1 (1OE), U4.19 (2OE), U14.4 (I3)
/~RESET: J1.115 (RESET), U14.13 (I11)
/~RFSH: J1.85 (RFSH), U1.6
/~STS_IOR: U7.1, U7.4, U7.10, U7.13, U14.19 (O8)
/~WR: J6.7 (GCLK0/GPIO4), RN2.10 (R9), U3.1 (1OE), U3.19 (2OE), U14.3 (I2)
/~pCON_SO: J6.21 (MISO0/GPIO9), U2.8
/~pINT: J6.32 (PWM0/GPIO12), RN2.4 (R3), U1.10, U7.12
/~pRFSH: J6.33 (PWM1/GPIO13), RN2.2 (R1), U1.5
unnamed: C1.1, R1.1, U11.7 (VREF2), U11.8 (EN)
unnamed: C6.1, J6.17 (3V3), U11.2 (VREF1)
unnamed: J2.15, U1.11
unnamed: J2.16, U1.8
unnamed: J3.2, J3.4, J3.6, J3.8, J3.10, U1.3
unnamed: J5.4, J6.10 (GPIO15/RXD)
unnamed: J5.5, J6.8 (GPIO14/TXD)
unnamed: J6.3 (SDA/GPIO2), U11.4 (SDA1)
unnamed: J6.5 (SCL/GPIO3), U11.3 (SCL1)
unnamed: RN1.2 (R1), SW1.11, U12.9 (R3)
unnamed: RN1.3 (R2), SW1.10, U12.12 (R4)
unnamed: RN1.4 (R3), SW1.9, U12.14 (R5)
unnamed: RN1.5 (R4), SW1.8, U12.16 (R6)
unnamed: RN1.6 (R5), SW1.7, U12.18 (R7)
unnamed: RN3.2 (R1), SW2.16, U13.3 (R0)
unnamed: RN3.3 (R2), SW2.15, U13.5 (R1)
unnamed: RN3.4 (R3), SW2.14, U13.7 (R2)
unnamed: RN3.5 (R4), SW2.13, U13.9 (R3)
unnamed: RN3.6 (R5), SW2.12, U13.12 (R4)
unnamed: RN3.7 (R6), SW2.11, U13.14 (R5)
unnamed: RN3.8 (R7), SW2.10, U13.16 (R6)
unnamed: RN3.9 (R8), SW2.9, U13.18 (R7)
unnamed: U12.1 (G), U13.19 (P=R)
unnamed: U12.19 (P=R), U14.5 (I4)

Notes on the sheet:
PiHoles
All Pi outputs should be open-collector or low while idle to avoid backfeeding power though the bus

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
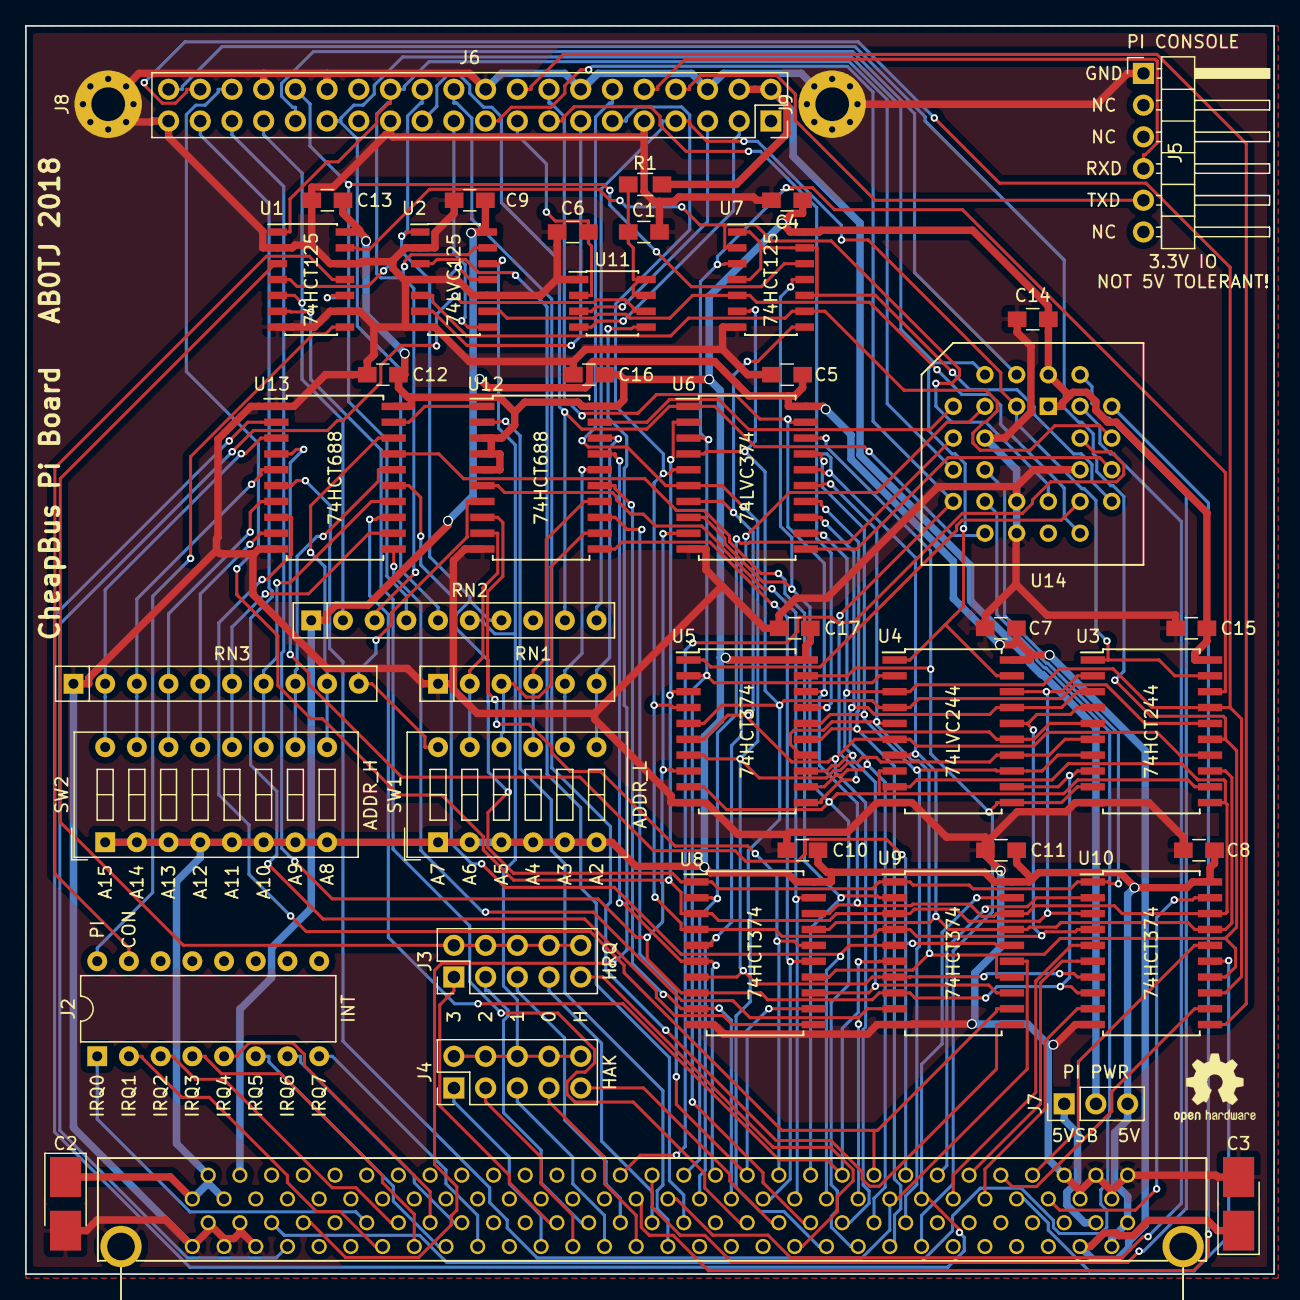
[picture p31: board Pi Board.kicad_pcb from above]

Board: 2 copper layers, 100.0 x 100.0 mm, 46 parts (0 on the bottom side), 119 nets.
