ab0tj/MiniSys/Software/PiBoard/pins.h

#ifndef INC_PINS_H
#define INC_PINS_H

/* Broadcom GPIO numbering */

#define PIN_AD0     16
#define PIN_AD1	    17
#define PIN_AD2	    18
#define PIN_AD3	    19
#define PIN_AD4	    20
#define PIN_AD5	    21
#define PIN_AD6	    22
#define PIN_AD7	    23

#define PIN_ALE_X	24
#define PIN_ALE_H	25
#define PIN_ALE_L	26

#define PIN_PI_REQ	27
#define PIN_INT	    12
#define PIN_RFSH	13

#define PIN_SV	    0
#define PIN_WR	    4
#define PIN_RD	    5
#define PIN_IOM	    6

#define PIN_HRQ	    7
#define PIN_HAK	    8

#define PIN_CON_SO	9
#define PIN_CON_SI  1
#define PIN_CON_W	10
#define PIN_CON_R	11

#endif
