ab0tj/MiniSys/(commit log)

2019-11-13 Tweak Pi read cycle time to eliminate (infrequent) errors
    [bus.cpp]
2020-03-27 C++ version of the PiBoard software now working
    [16MB DRAM-B.Cu.gbr, 16MB DRAM-B.Mask.gbr, 16MB DRAM-B.SilkS.gbr, 16MB DRAM-Edge.Cuts.gbr, 16MB DRAM-F.Cu.gbr, 16MB DRAM-F.Mask.gbr, 16MB DRAM-F.SilkS.gbr, 16MB DRAM-NPTH.drl]
2020-03-27 Added more files to git
    [MiniSys MicroSD.kicad_pcb, MiniSys MicroSD.sch]
2020-07-19 Add MicroSD CUPL files. Still untested.
    [MiniSys MicroSD-B_Cu.gbr, MiniSys MicroSD-B_Mask.gbr, MiniSys MicroSD-B_SilkS.gbr, MiniSys MicroSD-Edge_Cuts.gbr, MiniSys MicroSD-F_Cu.gbr, MiniSys MicroSD-F_Mask.gbr, MiniSys MicroSD-F_SilkS.gbr, MiniSys MicroSD-NPTH.drl]
